RF-Lab/emg-lab/myocell_s3/readme.md

# multiboard myocell-s3 design



ADC + CPU board for multiboard MYOCELL design. Includes [ADS1298(4)](https://static.chipdip.ru/lib/395/DOC009395274.pdf) and [ESP32-S3-WROOM-2](https://www.espressif.com/sites/default/files/documentation/esp32-s3-wroom-2_datasheet_en.pdf). Design based on ideas from [HeartyPatch](https://hackaday.io/project/21046-heartypatch-a-single-lead-ecg-hr-patch-with-esp32), [Adafruit Feather ESP32-S3](https://learn.adafruit.com/assets/110822), [electronics-homeassistant-lightscontroll
](https://github.com/crgarcia12/electronics-homeassistant-lightscontroll) etc.

## Revision history
[]() Sent to rezonit 2026.03.16

* BOM: [Interactive BOM ()](https://htmlpreview.github.io/?https://github.com/RF-Lab/emg-lab/blob/main/myocell_s3/bom/ibom.html)

### Top View
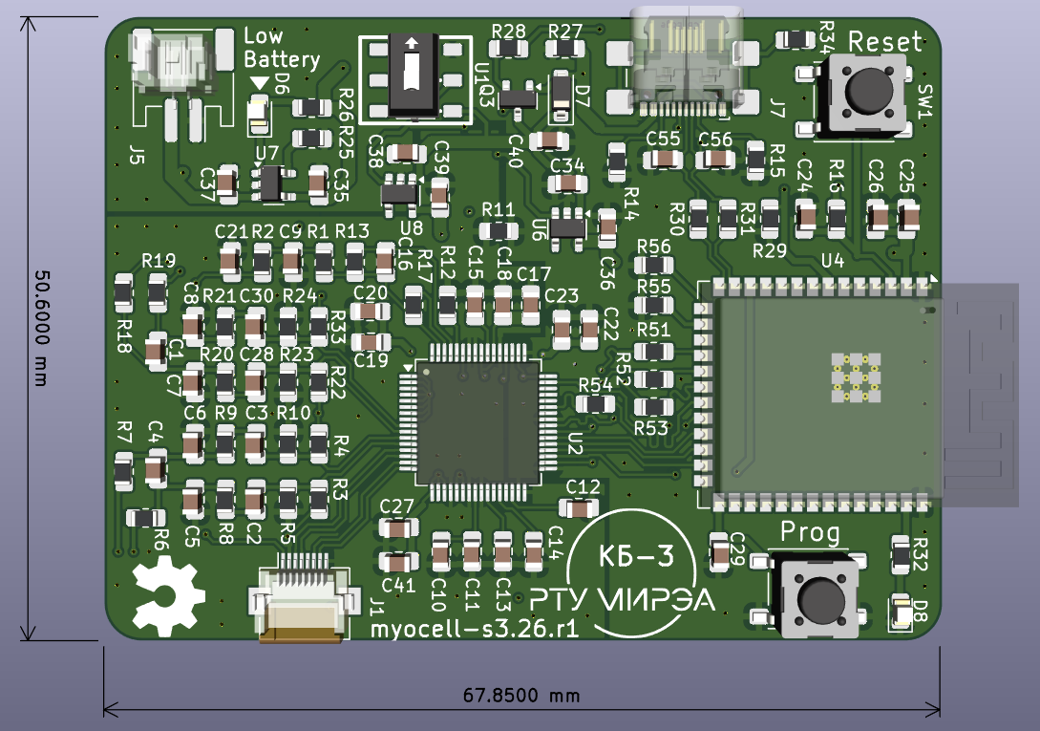
[picture p1: myocell_s3/3d.png]


### Bottom View
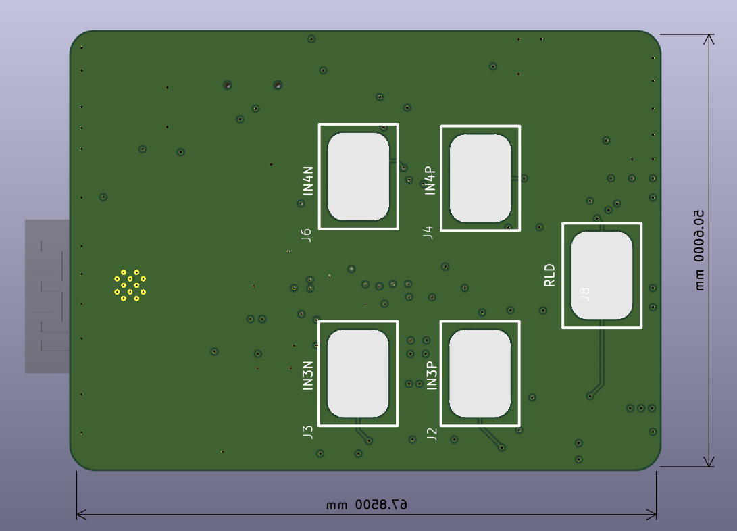
[picture p2: myocell_s3/3d_back.png]


## Gerbers

### Top+Silkscreen
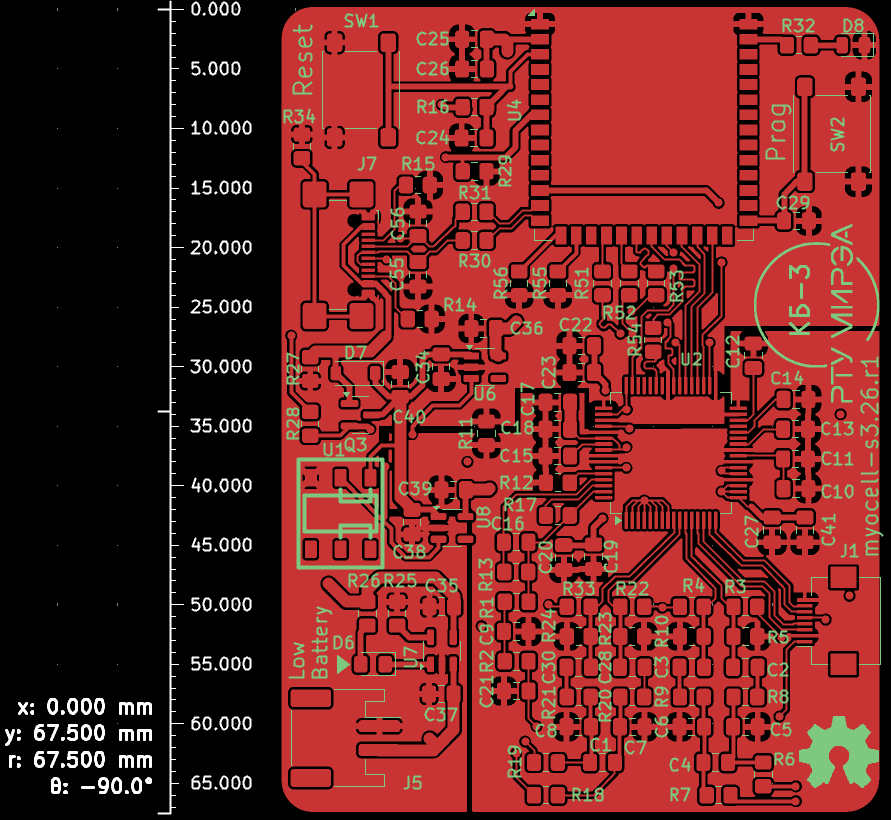
[picture p3: myocell_s3/g_top.png]


### Inner 1 (under the top)
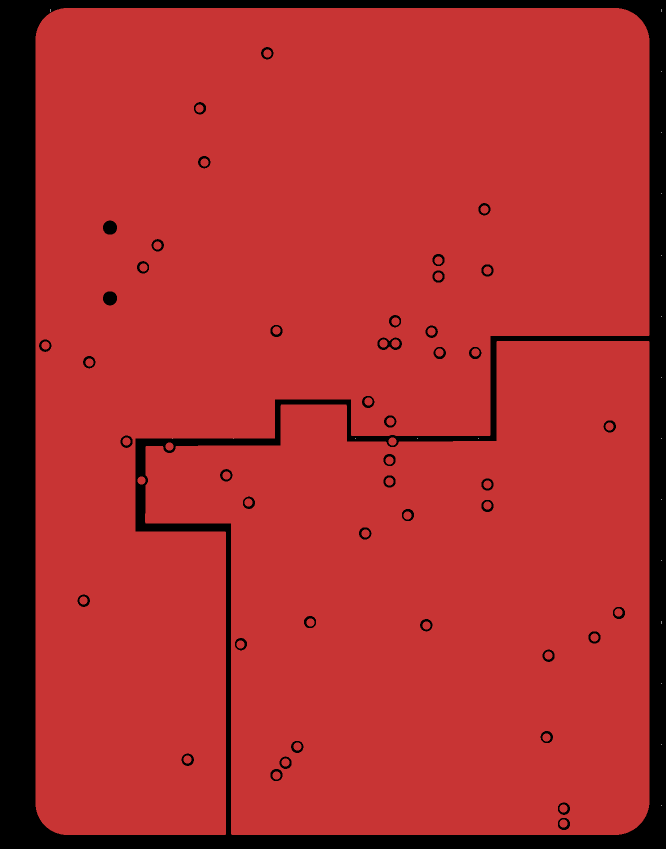
[picture p4: myocell_s3/g_in1.png]


### Inner 2
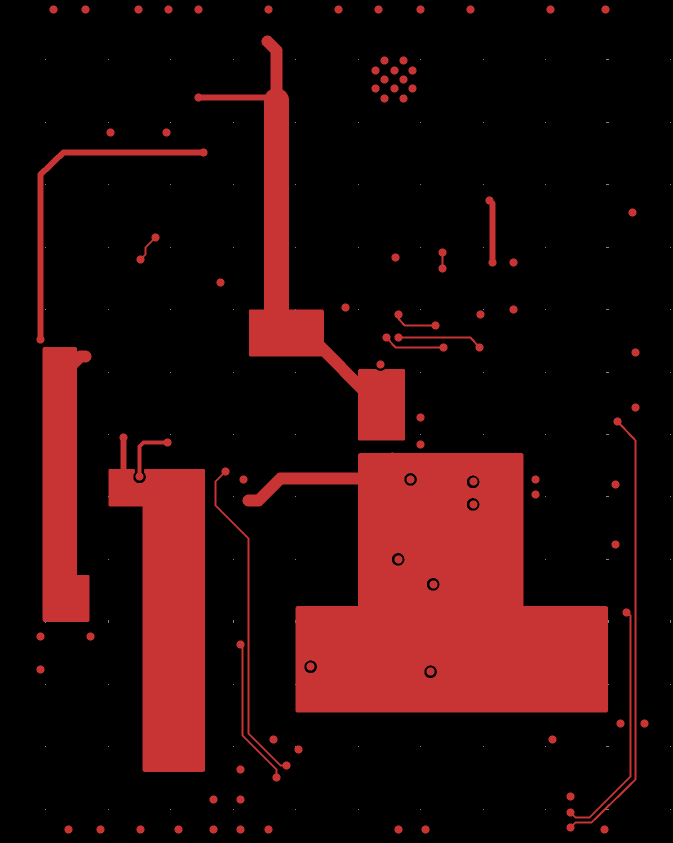
[picture p5: myocell_s3/g_in2.png]


### Bottom+Silkscreen
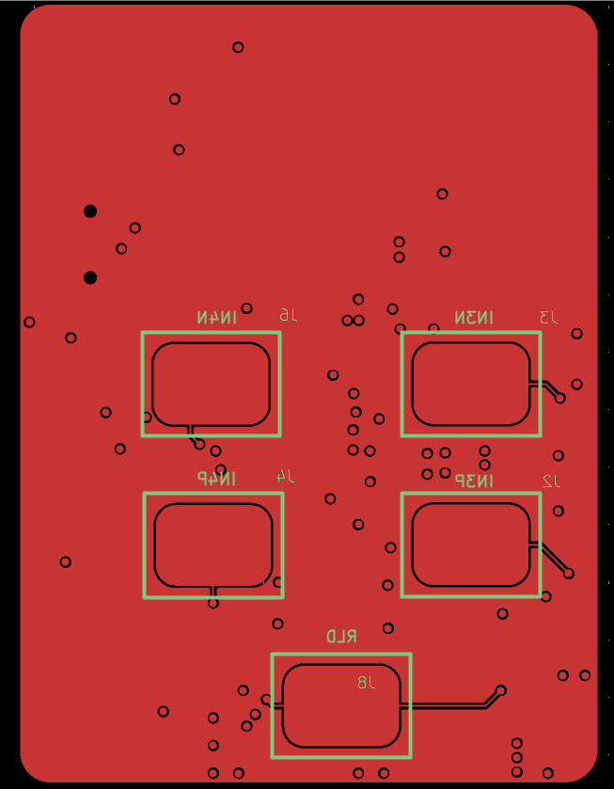
[picture p6: myocell_s3/g_bot.png]


## Dependencies

* [Espressif KiCad Library](https://github.com/espressif/kicad-libraries)
