RF-Lab/emg-lab/myocell_s3/myocell_s3.pdf

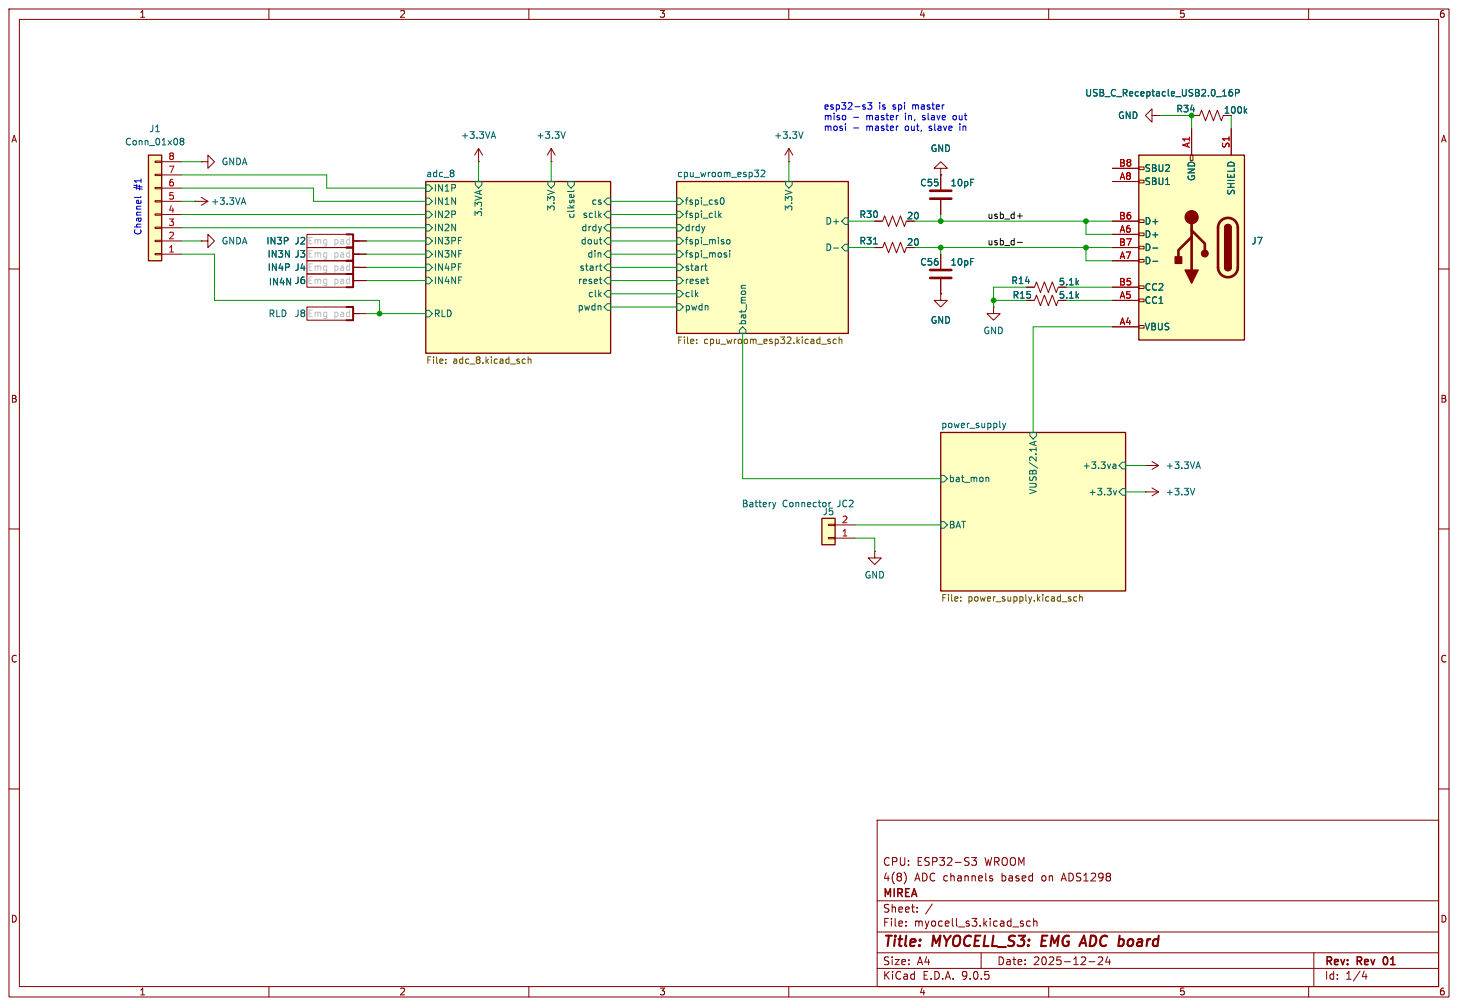
[picture p7: page 1]

clk clksel start dout drdy

IN3N J3 Emg pad
IN4P J4 Emg pad
IN4N J6 Emg pad RLD J8 Emg pad

Id: 1/4 Title: MYOCELL_S3: EMG ADC board

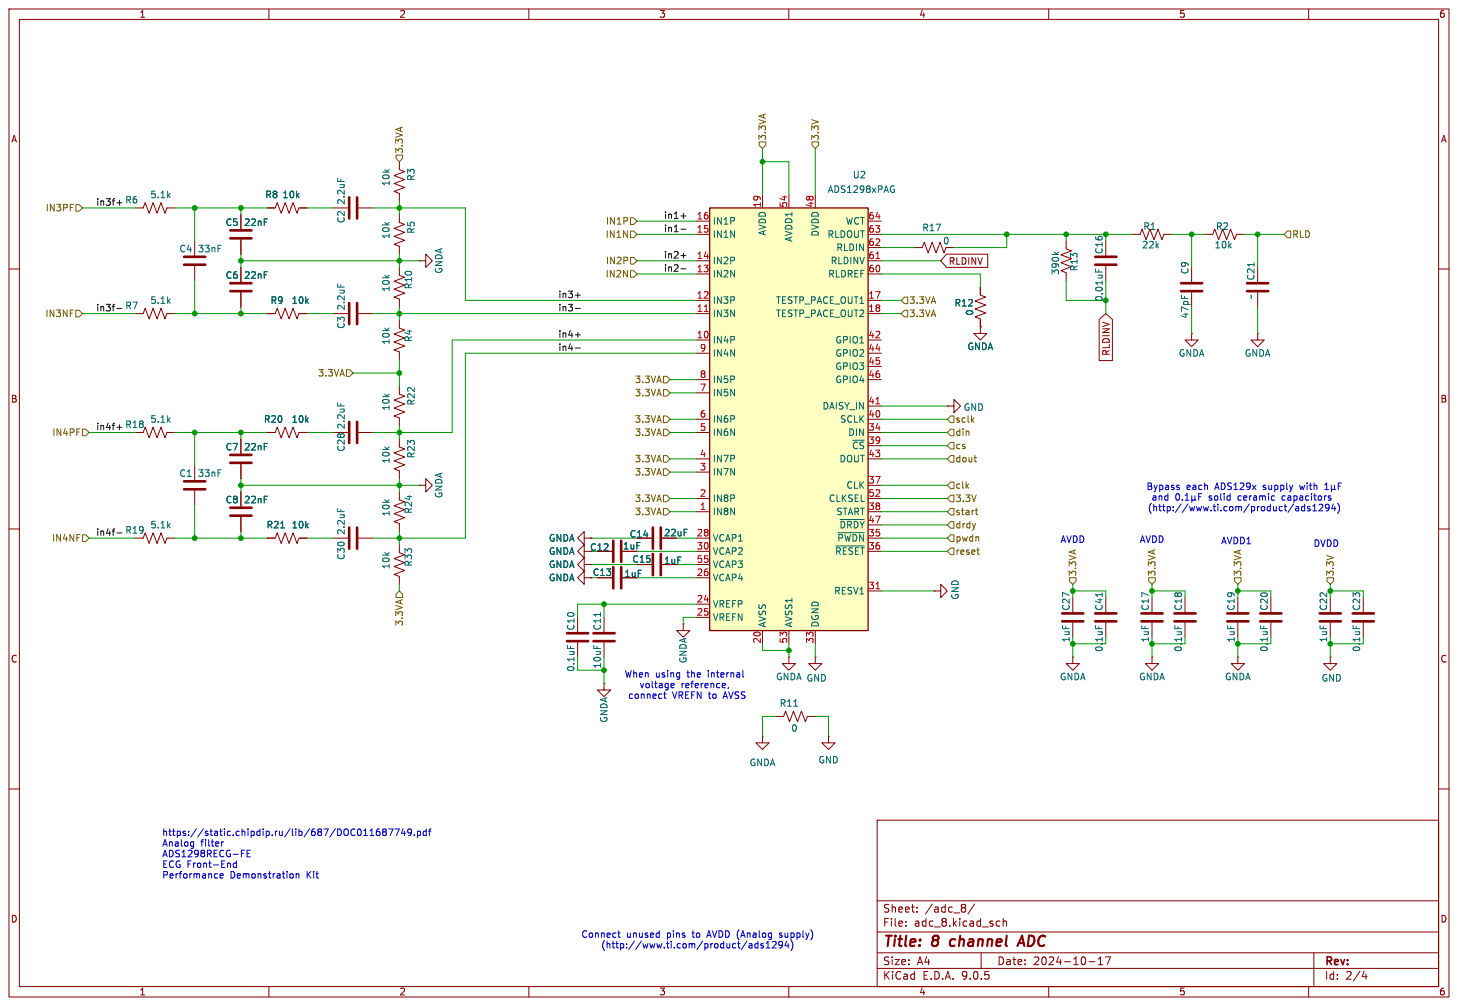
[picture p8: page 2]

(http://www.ti.com/product/ads1294) Connect unused pins to AVDD (Analog supply)

and þÿ0.1¼F solid ceramic capacitors

https://static.chipdip.ru/lib/687/DOC011687749.pdf
Analog filter ADS1298RECG-FE

File: adc_8.kicad_sch Sheet: /adc_8/
Id: 2/4 Title: 8 channel ADC

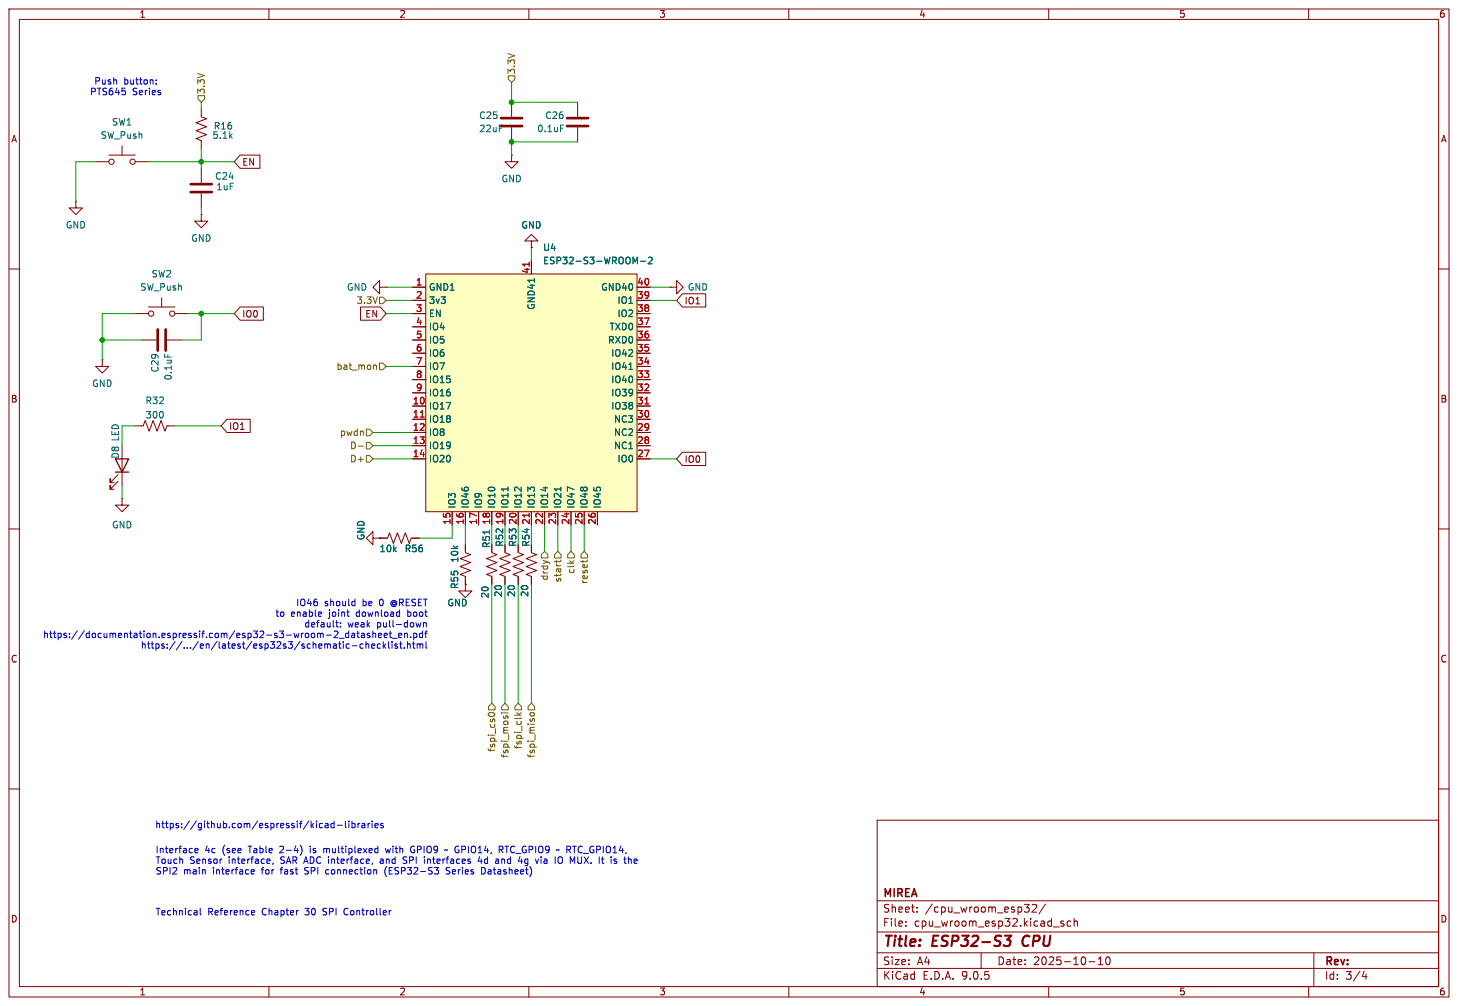
[picture p9: page 3]

https://documentation.espressif.com/esp32-s3-wroom-2_datasheet_en.pdf

https://.../en/latest/esp32s3/schematic-checklist.html

https://github.com/espressif/kicad-libraries

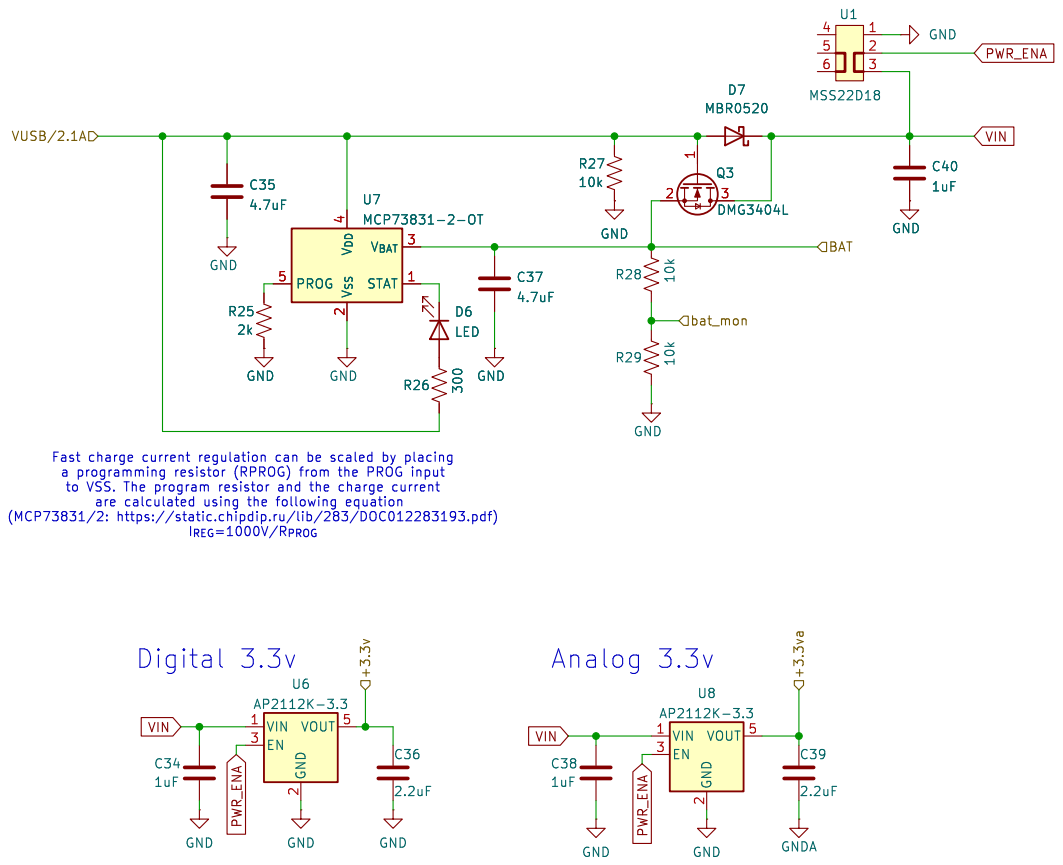
[picture p10: page 4]

MIREA/Rf-lab.org
File: power_supply.kicad_sch Sheet: /power_supply/
Id: 5/4 Title: Power supply
