RF-Lab/emg-lab/myocell_s3/myocell_s3.kicad_pcb

## KiCad design myocell_s3/myocell_s3.kicad_pcb (2026-03-15)

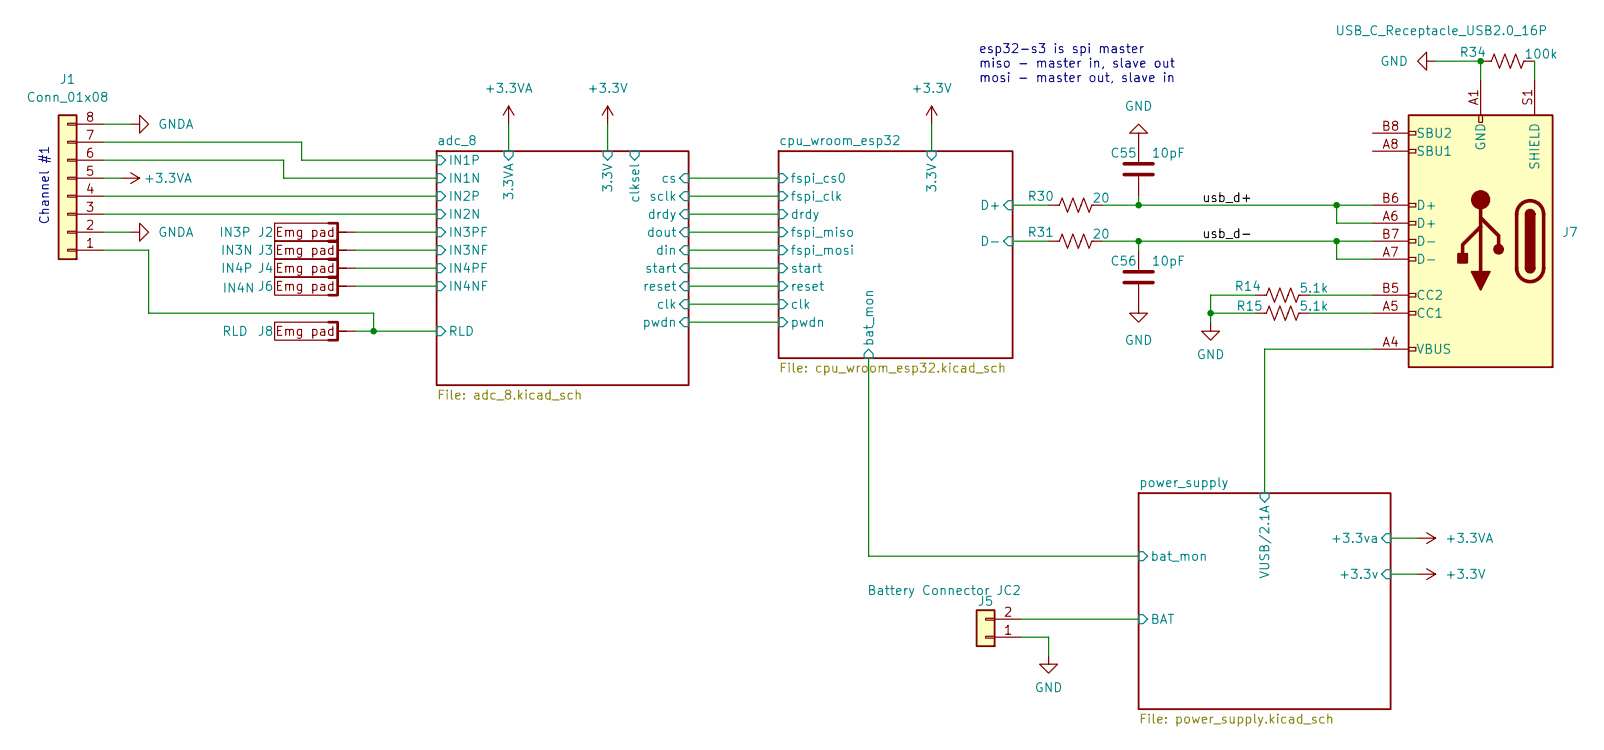
[picture p11: schematic myocell_s3.kicad_sch, MYOCELL_S3: EMG ADC board]

Parts:
C55, C56: 10pF; C_0805_2012Metric_Pad1.18x1.45mm_HandSolder
J1: Conn_01x08; Hirose_FH12-8S-0.5SH_1x08-1MP_P0.50mm_Horizontal
J2: IN3P; EMG_PAD_10_7
J3: IN3N; EMG_PAD_10_7
J4: IN4P; EMG_PAD_10_7
J5: Battery Connector JC2; JST_PH_S2B-PH-SM4-TB_1x02-1MP_P2.00mm_Horizontal
J6: IN4N; EMG_PAD_10_7
J7: USB_C_Receptacle_USB2.0_16P; USB_C_Receptacle_GCT_USB4110
J8: RLD; EMG_PAD_10_7
R14, R15: 5.1k; R_0805_2012Metric_Pad1.20x1.40mm_HandSolder
R30, R31: 20; R_0805_2012Metric_Pad1.20x1.40mm_HandSolder
R34: 100k; R_0805_2012Metric_Pad1.20x1.40mm_HandSolder

Connections:
+3.3VA: J1.5; also elsewhere on the board
/adc_8/RLD: J1.1, J8.1; also elsewhere on the board
/adc_8/in1+: J1.7; also elsewhere on the board
/adc_8/in1-: J1.6; also elsewhere on the board
/adc_8/in2+: J1.4; also elsewhere on the board
/adc_8/in2-: J1.3; also elsewhere on the board
/adc_8/in3f+: J2.1; also elsewhere on the board
/adc_8/in3f-: J3.1; also elsewhere on the board
/adc_8/in4f+: J4.1; also elsewhere on the board
/adc_8/in4f-: J6.1; also elsewhere on the board
/cpu_wroom_esp32/D+: R30.1; also elsewhere on the board
/cpu_wroom_esp32/D-: R31.1; also elsewhere on the board
/power_supply/BAT: J5.2; also elsewhere on the board
/power_supply/VUSB/2.1A: J7.A4 (VBUS), J7.A9 (VBUS), J7.B4 (VBUS), J7.B9 (VBUS); also elsewhere on the board
/usb_d+: C55.2, J7.A6 (D+), J7.B6 (D+), R30.2
/usb_d-: C56.1, J7.A7 (D-), J7.B7 (D-), R31.2
GND: C55.1, C56.2, J5.1, J7.A1 (GND), J7.A12 (GND), J7.B1 (GND), J7.B12 (GND), R14.1, R15.1, R34.1; also elsewhere on the board
GNDA: J1.2, J1.8; also elsewhere on the board
unnamed: J7.A5 (CC1), R15.2
unnamed: J7.B5 (CC2), R14.2
unnamed: J7.S1 (SHIELD), R34.2

Notes on the sheet:
esp32-s3 is spi master miso - master in, slave out mosi - master out, slave in
Channel #1

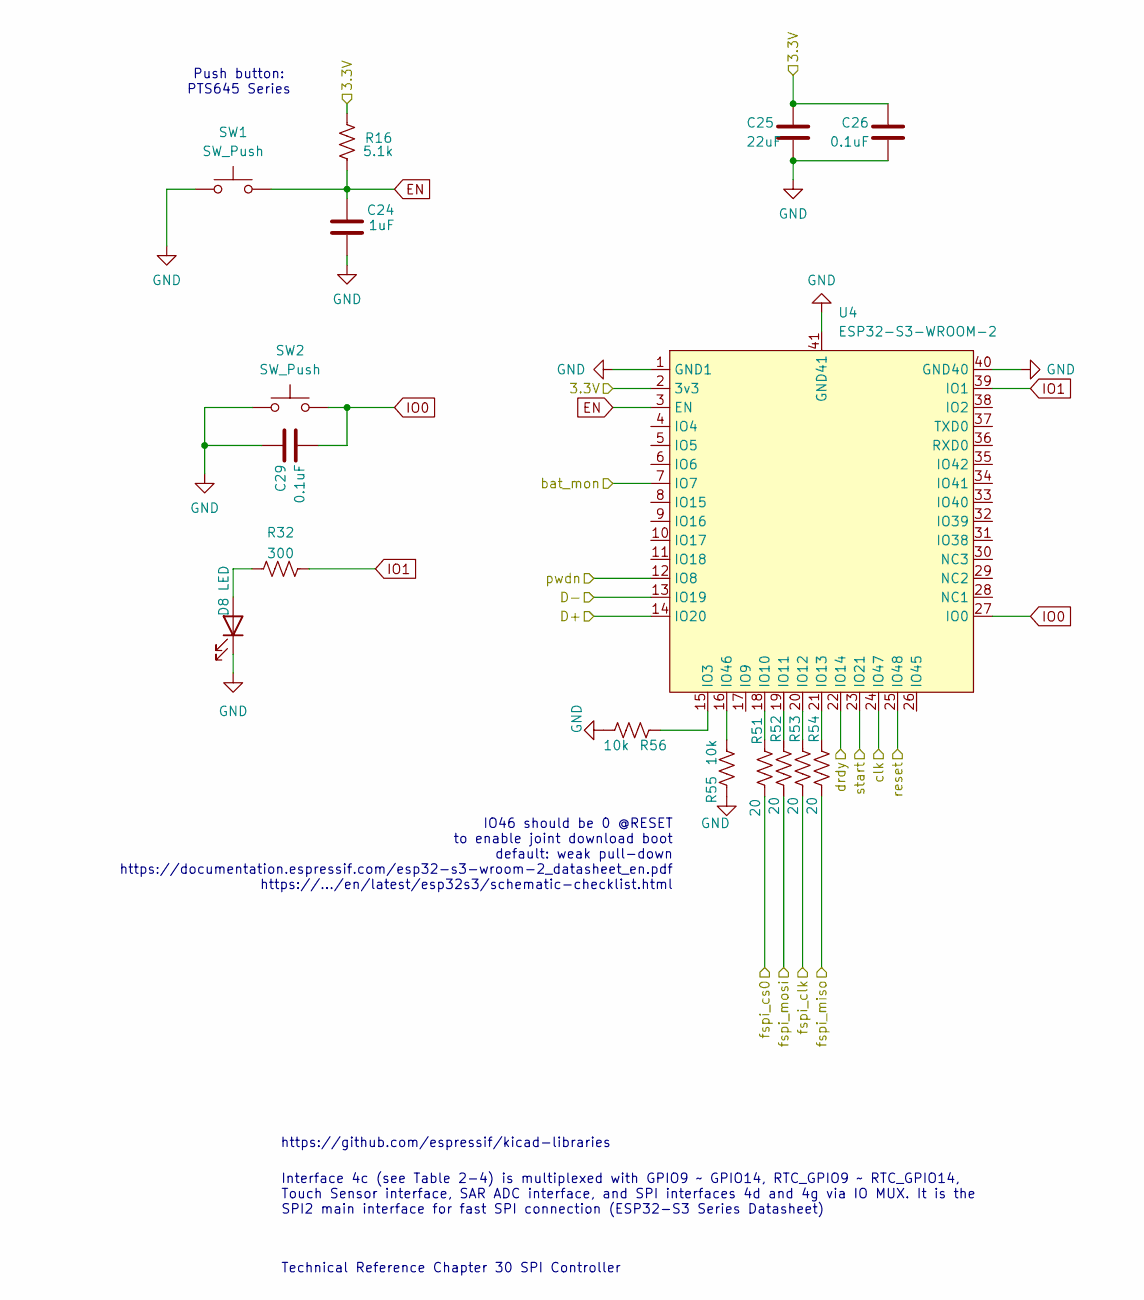
[picture p12: schematic cpu_wroom_esp32.kicad_sch, ESP32-S3 CPU]

Parts:
C24: 1uF; C_0805_2012Metric_Pad1.18x1.45mm_HandSolder
C25: 22uF; C_0805_2012Metric_Pad1.18x1.45mm_HandSolder
C26, C29: 0.1uF; C_0805_2012Metric_Pad1.18x1.45mm_HandSolder
D8: LED; LED_0805_2012Metric
R16: 5.1k; R_0805_2012Metric_Pad1.20x1.40mm_HandSolder
R32: 300; R_0805_2012Metric_Pad1.20x1.40mm_HandSolder
R51, R52, R53, R54: 20; R_0805_2012Metric_Pad1.20x1.40mm_HandSolder
R55, R56: 10k; R_0805_2012Metric_Pad1.20x1.40mm_HandSolder
SW1, SW2: SW_Push; SW_SPST_PTS645Sx43SMTR92
U4: ESP32-S3-WROOM-2

Connections:
+3.3V: C25.2, C26.2, R16.2, U4.2 (3v3); also elsewhere on the board
/adc_8/clk: U4.24 (IO47); also elsewhere on the board
/adc_8/cs: R51.1; also elsewhere on the board
/adc_8/din: R52.1; also elsewhere on the board
/adc_8/dout: R54.1; also elsewhere on the board
/adc_8/drdy: U4.22 (IO14); also elsewhere on the board
/adc_8/pwdn: U4.12 (IO8); also elsewhere on the board
/adc_8/reset: U4.25 (IO48); also elsewhere on the board
/adc_8/sclk: R53.1; also elsewhere on the board
/adc_8/start: U4.23 (IO21); also elsewhere on the board
/cpu_wroom_esp32/D+: U4.14 (IO20); also elsewhere on the board
/cpu_wroom_esp32/D-: U4.13 (IO19); also elsewhere on the board
/cpu_wroom_esp32/bat_mon: U4.7 (IO7); also elsewhere on the board
EN: C24.2, R16.1, SW1.2, U4.3 (EN)
GND: C24.1, C25.1, C26.1, C29.2, D8.1 (K), R55.1, R56.2, SW1.1, SW2.1, U4.1 (GND1), U4.40 (GND40), U4.41 (GND41); also elsewhere on the board
IO0: C29.1, SW2.2, U4.27 (IO0)
IO1: R32.2, U4.39 (IO1)
unnamed: D8.2 (A), R32.1
unnamed: R56.1, U4.15 (IO3)
unnamed: R51.2, U4.18 (IO10)
unnamed: R52.2, U4.19 (IO11)
unnamed: R53.2, U4.20 (IO12)
unnamed: R54.2, U4.21 (IO13)
unnamed: R55.2, U4.16 (IO46)

Notes on the sheet:
Technical Reference Chapter 30 SPI Controller
IO46 should be 0 @RESET to enable joint download boot default: weak pull-down https://documentation.espressif.com/esp32-s3-wroom-2_datasheet_en.pdf https://.../en/latest/esp32s3/schematic-checklist.html
Interface 4c (see Table 2-4) is multiplexed with GPIO9 ~ GPIO14, RTC_GPIO9 ~ RTC_GPIO14, Touch Sensor interface, SAR ADC interface, and SPI interfaces 4d and 4g via IO MUX. It is the SPI2 main interface for fast SPI connection (ESP32-S3 Series Datasheet)
Push button: PTS645 Series
https://github.com/espressif/kicad-libraries

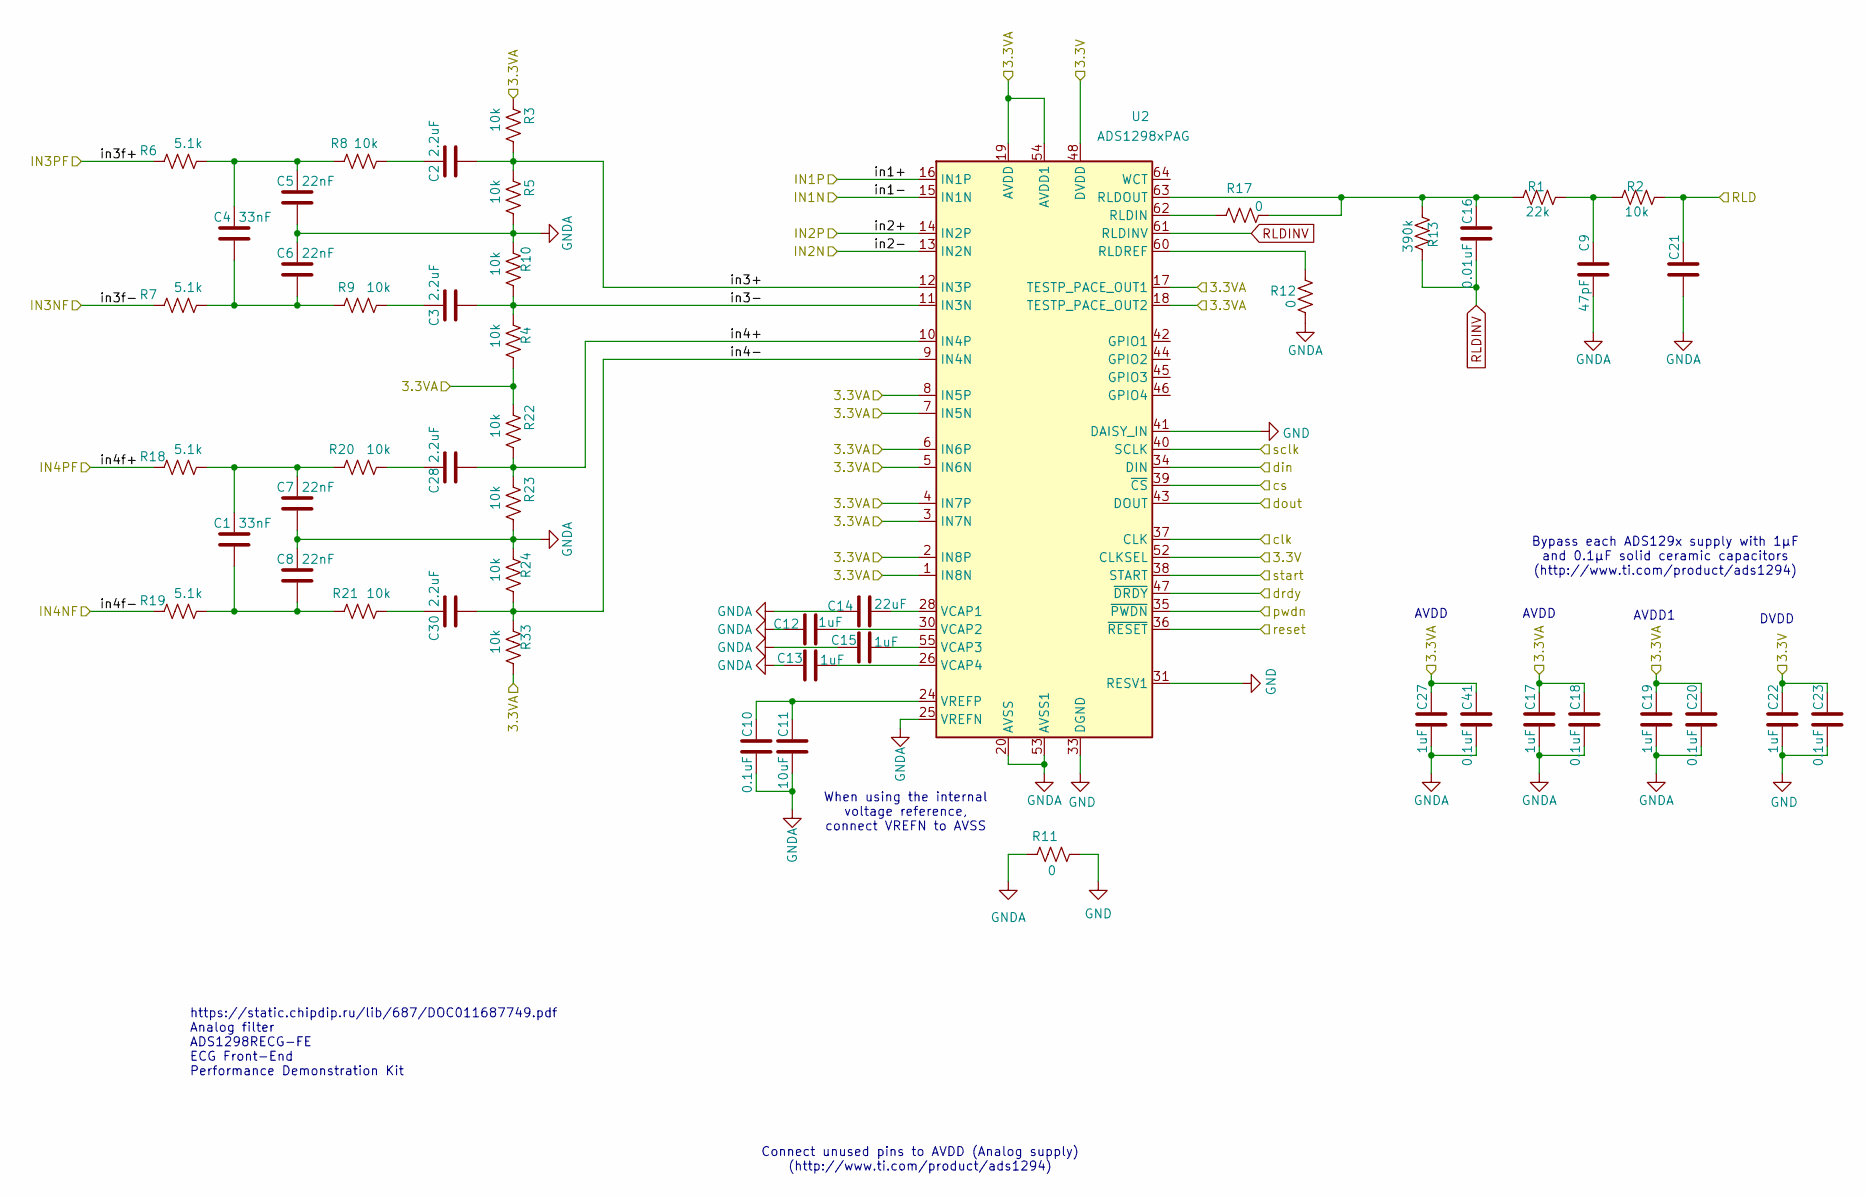
[picture p13: schematic adc_8.kicad_sch, 8 channel ADC]

Parts:
C1, C4: 33nF; C_0805_2012Metric_Pad1.18x1.45mm_HandSolder
C2, C3, C28, C30: 2.2uF; C_0805_2012Metric_Pad1.18x1.45mm_HandSolder
C5, C6, C7, C8: 22nF; C_0805_2012Metric_Pad1.18x1.45mm_HandSolder
C9: 47pF; C_0805_2012Metric_Pad1.18x1.45mm_HandSolder
C10, C18, C20, C23, C41: 0.1uF; C_0805_2012Metric_Pad1.18x1.45mm_HandSolder
C11: 10uF; C_0805_2012Metric_Pad1.18x1.45mm_HandSolder
C12, C13, C15, C17, C19, C22, C27: 1uF; C_0805_2012Metric_Pad1.18x1.45mm_HandSolder
C14: 22uF; C_0805_2012Metric_Pad1.18x1.45mm_HandSolder
C16: 0.01uF; C_0805_2012Metric_Pad1.18x1.45mm_HandSolder
C21: C_0805_2012Metric_Pad1.18x1.45mm_HandSolder
R1: 22k; R_0805_2012Metric_Pad1.20x1.40mm_HandSolder
R2, R3, R4, R5, R8, R9, R10, R20, R21, R22, R23, R24, R33: 10k; R_0805_2012Metric_Pad1.20x1.40mm_HandSolder
R6, R7, R18, R19: 5.1k; R_0805_2012Metric_Pad1.20x1.40mm_HandSolder
R11, R12, R17: 0; R_0805_2012Metric_Pad1.20x1.40mm_HandSolder
R13: 390k; R_0805_2012Metric_Pad1.20x1.40mm_HandSolder
U2: ADS1298xPAG; TQFP-64_10x10mm_P0.5mm

Connections:
+3.3V: C22.2, C23.2, U2.48 (DVDD), U2.50 (DVDD), U2.52 (CLKSEL); also elsewhere on the board
+3.3VA: C17.2, C18.2, C19.2, C20.2, C27.2, C41.2, R3.2, R4.1, R22.2, R33.1, U2.1 (IN8N), U2.2 (IN8P), U2.3 (IN7N), U2.4 (IN7P), U2.5 (IN6N), U2.6 (IN6P), U2.7 (IN5N), U2.8 (IN5P), U2.17 (TESTP_PACE_OUT1), U2.18 (TESTP_PACE_OUT2), U2.19 (AVDD), U2.21 (AVDD), U2.22 (AVDD), U2.54 (AVDD1), U2.56 (AVDD), U2.59 (AVDD); also elsewhere on the board
/adc_8/RLD: C21.2, R2.2; also elsewhere on the board
/adc_8/clk: U2.37 (CLK); also elsewhere on the board
/adc_8/cs: U2.39 (~CS); also elsewhere on the board
/adc_8/din: U2.34 (DIN); also elsewhere on the board
/adc_8/dout: U2.43 (DOUT); also elsewhere on the board
/adc_8/drdy: U2.47 (~DRDY); also elsewhere on the board
/adc_8/in1+: U2.16 (IN1P); also elsewhere on the board
/adc_8/in1-: U2.15 (IN1N); also elsewhere on the board
/adc_8/in2+: U2.14 (IN2P); also elsewhere on the board
/adc_8/in2-: U2.13 (IN2N); also elsewhere on the board
/adc_8/in3+: C2.2, R3.1, R5.2, U2.12 (IN3P)
/adc_8/in3-: C3.2, R4.2, R10.1, U2.11 (IN3N)
/adc_8/in3f+: R6.1; also elsewhere on the board
/adc_8/in3f-: R7.1; also elsewhere on the board
/adc_8/in4+: C28.2, R22.1, R23.2, U2.10 (IN4P)
/adc_8/in4-: C30.2, R24.1, R33.2, U2.9 (IN4N)
/adc_8/in4f+: R18.1; also elsewhere on the board
/adc_8/in4f-: R19.1; also elsewhere on the board
/adc_8/pwdn: U2.35 (~PWDN); also elsewhere on the board
/adc_8/reset: U2.36 (~RESET); also elsewhere on the board
/adc_8/sclk: U2.40 (SCLK); also elsewhere on the board
/adc_8/start: U2.38 (START); also elsewhere on the board
GND: C22.1, C23.1, R11.1, U2.31 (RESV1), U2.33 (DGND), U2.41 (DAISY_IN), U2.49 (DGND), U2.51 (DGND); also elsewhere on the board
GNDA: C5.2, C6.1, C7.2, C8.1, C9.1, C10.1, C11.1, C12.2, C13.2, C14.2, C15.2, C17.1, C18.1, C19.1, C20.1, C21.1, C27.1, C41.1, R5.1, R10.2, R11.2, R12.1, R23.1, R24.2, U2.20 (AVSS), U2.23 (AVSS), U2.25 (VREFN), U2.32 (AVSS), U2.53 (AVSS1), U2.57 (AVSS), U2.58 (AVSS); also elsewhere on the board
unnamed: C1.1, C7.1, R18.2, R20.1
unnamed: C1.2, C8.2, R19.2, R21.1
unnamed: C2.1, R8.2
unnamed: C3.1, R9.2
unnamed: C4.1, C5.1, R6.2, R8.1
unnamed: C4.2, C6.2, R7.2, R9.1
unnamed: C9.2, R1.2, R2.1
unnamed: C28.1, R20.2
unnamed: C30.1, R21.2
unnamed: R17.2, U2.62 (RLDIN)
unnamed: C16.2, R1.1, R13.1, R17.1, U2.63 (RLDOUT)
unnamed: R12.2, U2.60 (RLDREF)
unnamed: C14.1, U2.28 (VCAP1)
unnamed: C12.1, U2.30 (VCAP2)
unnamed: C15.1, U2.55 (VCAP3)
unnamed: C13.1, U2.26 (VCAP4)
unnamed: C10.2, C11.2, U2.24 (VREFP)
RLDINV: C16.1, R13.2, U2.61 (RLDINV)

Notes on the sheet:
When using the internal voltage reference, connect VREFN to AVSS
DVDD
Connect unused pins to AVDD (Analog supply) (http://www.ti.com/product/ads1294)
AVDD
AVDD1
Bypass each ADS129x supply with 1μF and 0.1μF solid ceramic capacitors (http://www.ti.com/product/ads1294)
https://static.chipdip.ru/lib/687/DOC011687749.pdf Analog filter ADS1298RECG-FE ECG Front-End Performance Demonstration Kit

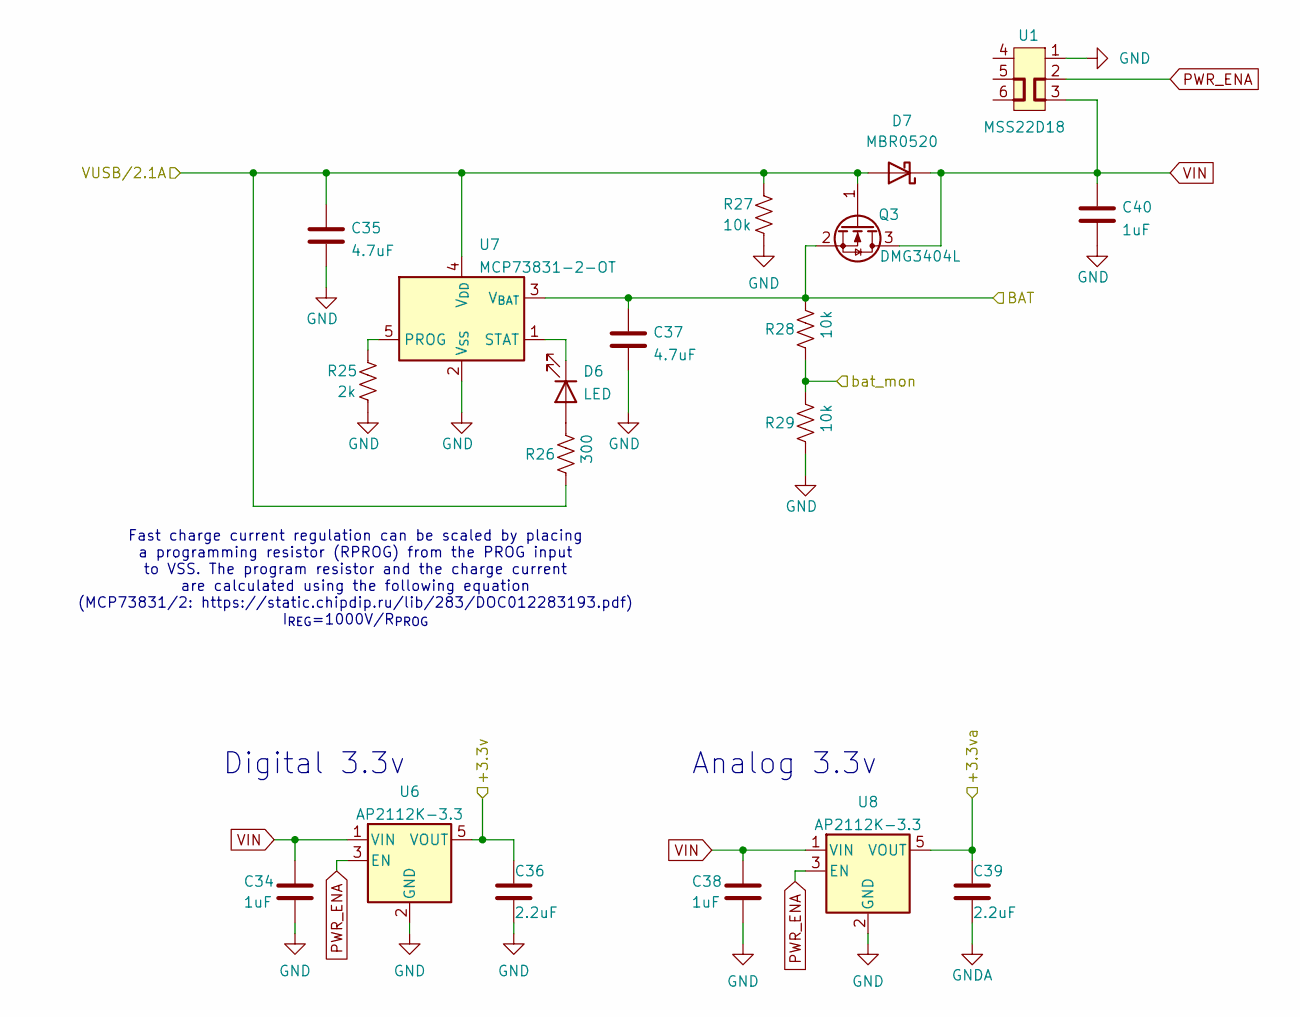
[picture p14: schematic power_supply.kicad_sch, Power supply]

Parts:
C34, C38, C40: 1uF; C_0805_2012Metric_Pad1.18x1.45mm_HandSolder
C35, C37: 4.7uF; C_0805_2012Metric_Pad1.18x1.45mm_HandSolder
C36, C39: 2.2uF; C_0805_2012Metric_Pad1.18x1.45mm_HandSolder
D6: LED; LED_0805_2012Metric_Pad1.15x1.40mm_HandSolder
D7: MBR0520; D_SOD-123
Q3: DMG3404L; SOT-23
R25: 2k; R_0805_2012Metric_Pad1.20x1.40mm_HandSolder
R26: 300; R_0805_2012Metric_Pad1.20x1.40mm_HandSolder
R27, R28, R29: 10k; R_0805_2012Metric_Pad1.20x1.40mm_HandSolder
U1: MSS22D18
U6, U8: AP2112K-3.3; SOT-23-5
U7: MCP73831-2-OT; SOT-23-5

Connections:
+3.3V: C36.2, U6.5 (VOUT); also elsewhere on the board
+3.3VA: C39.2, U8.5 (VOUT); also elsewhere on the board
/cpu_wroom_esp32/bat_mon: R28.1, R29.2; also elsewhere on the board
/power_supply/BAT: C37.1, Q3.2 (S), R28.2, U7.3 (V_{BAT}); also elsewhere on the board
/power_supply/VUSB/2.1A: C35.2, D7.2 (A), Q3.1 (G), R26.1, R27.2, U7.4 (V_{DD}); also elsewhere on the board
GND: C34.1, C35.1, C36.1, C37.2, C38.1, C40.1, R25.1, R27.1, R29.1, U1.1, U6.2 (GND), U7.2 (V_{SS}), U8.2 (GND); also elsewhere on the board
GNDA: C39.1; also elsewhere on the board
unnamed: D6.2 (A), R26.2
unnamed: D6.1 (K), U7.1 (STAT)
unnamed: R25.2, U7.5 (PROG)
PWR_ENA: U1.2, U6.3 (EN), U8.3 (EN)
VIN: C34.2, C38.2, C40.2, D7.1 (K), Q3.3 (D), U1.3, U6.1 (VIN), U8.1 (VIN)

Notes on the sheet:
Fast charge current regulation can be scaled by placing a programming resistor (RPROG) from the PROG input to VSS. The program resistor and the charge current are calculated using the following equation (MCP73831/2: https://static.chipdip.ru/lib/283/DOC012283193.pdf) I_{REG}=1000V/R_{PROG}
Analog 3.3v
Digital 3.3v

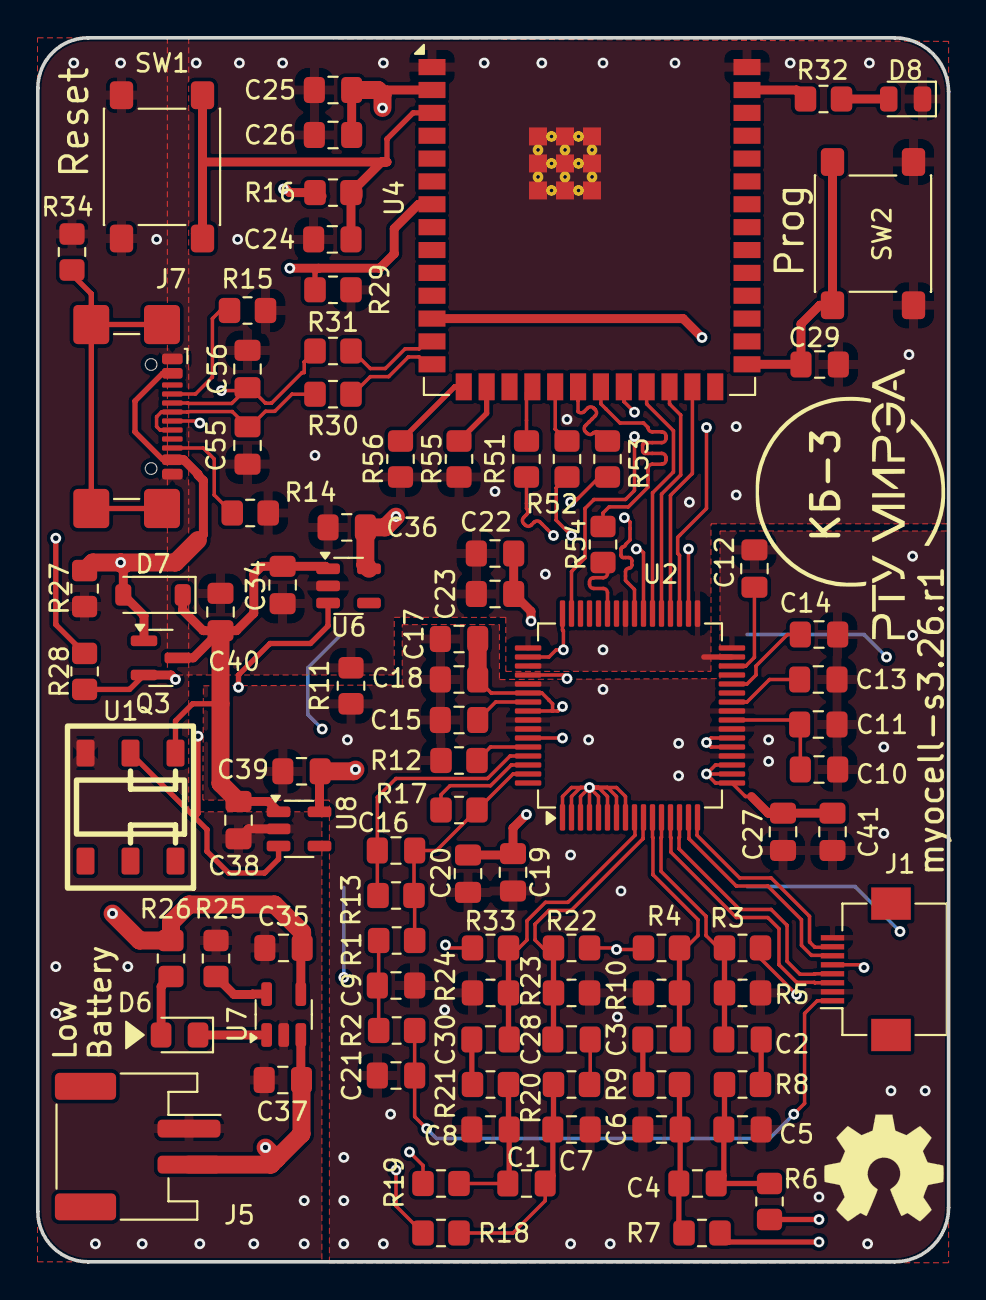
[picture p15: board myocell_s3.kicad_pcb from above]

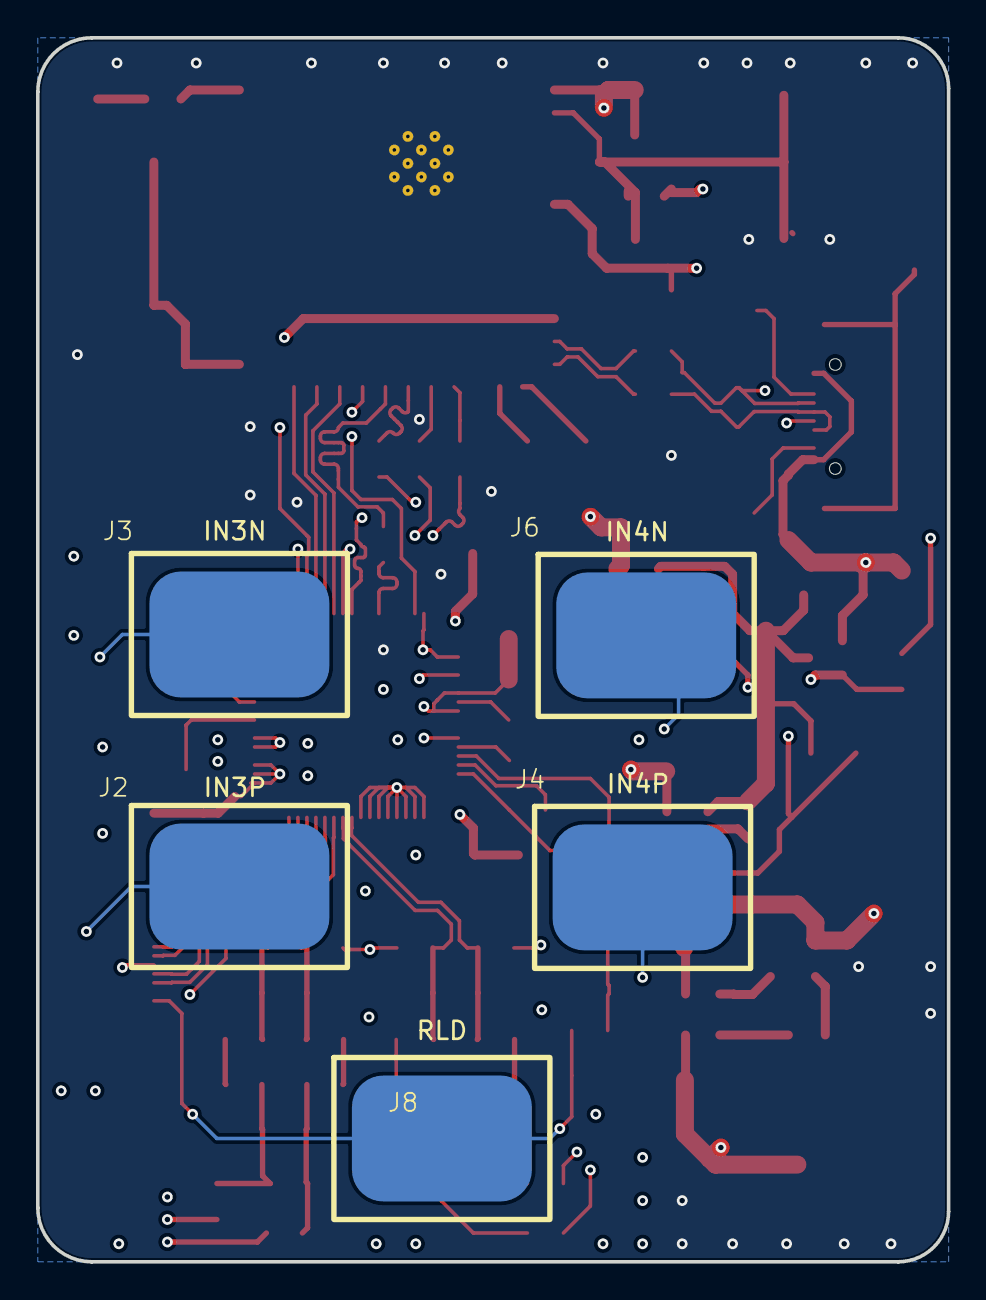
[picture p16: board myocell_s3.kicad_pcb from below]

Board: 4 copper layers, 50.6 x 68.0 mm, 100 parts (5 on the bottom side), 69 nets.
