RF-Lab/emg-lab/emg8x-s3.26.r1/main/app_main.c

//
// Copyright 2019-2026 rf-lab.org
// (MIREA KB-2( frmly. MIREA KB-3, MGUPI IT-6 "Control and simulation in technical systems"))
//
// Licensed under the Apache License, Version 2.0 (the "License");
// you may not use this file except in compliance with the License.
// You may obtain a copy of the License at

//     http://www.apache.org/licenses/LICENSE-2.0
//
// Unless required by applicable law or agreed to in writing, software
// distributed under the License is distributed on an "AS IS" BASIS,
// WITHOUT WARRANTIES OR CONDITIONS OF ANY KIND, either express or implied.
// See the License for the specific language governing permissions and
// limitations under the License.

// EMG-8x/app_main.c - main source file for EMG-8x hardware platform
// Please refer to:

// EMG platform
//      https://github.com/RF-Lab/emg_platform

// How to install SDK for ESP32 under Windows(r)
//      http://rf-lab.org/news/2020/04/04/esp-idf.html

// List of modifications:
//      https://github.com/RF-Lab/emg_platform/commits/master/source/esp32/emg8x/main/app_main.c
//

#include <stdio.h>
#include <stdint.h>
#include <stddef.h>
#include <string.h>
#include "esp_wifi.h"
#include "esp_system.h"
#include "nvs_flash.h"
#include "esp_event.h"

#include "freertos/FreeRTOS.h"
#include "freertos/task.h"
#include "freertos/semphr.h"
#include "freertos/queue.h"
#include "freertos/event_groups.h"

#include "lwip/sockets.h"
#include "lwip/dns.h"
#include "lwip/netdb.h"

#include "esp_log.h"
#include "hal/gpio_types.h"
#include "driver/gpio.h"
#include "driver/spi_master.h"
#include "esp_attr.h"

#include  "esp_chip_info.h"

static const char *TAG                          = "EMG8x" ;

// Pinout mapping
// Use pinout rules from here: (https://randomnerdtutorials.com/esp32-pinout-reference-gpios/)
// NodeMCU 32-s2 pinout: (https://www.instructables.com/id/ESP32-Internal-Details-and-Pinout/)

// DEBUG purpose pins
//static const gpio_num_t     DEBUG_PIN1          = GPIO_NUM_27 ;         // Debug pin #1
static const gpio_num_t         ESP_LED1          = GPIO_NUM_2 ;         // Debug pin #1

static const gpio_num_t     AD1299_PWDN_PIN     = GPIO_NUM_8 ;          // ADS<--ESP Power down pin (active low)
static const gpio_num_t     AD1299_RESET_PIN    = GPIO_NUM_48 ;         // ADS<--ESP Reset pin (active low)
static const gpio_num_t     AD1299_DRDY_PIN     = GPIO_NUM_14 ;         // ADS-->ESP DRDY pin (active low)
static const gpio_num_t     AD1299_START_PIN    = GPIO_NUM_21 ;         // ADS<--ESP Start data conversion pint (active high)

// SPI comands (see https://www.ti.com/lit/ds/symlink/ads1299.pdf?ts=1599826124971)
static const uint8_t        AD1299_CMD_RREG     = 0x20 ;                // Read register
static const uint8_t        AD1299_CMD_WREG     = 0x40 ;                // Write to register
static const uint8_t        AD1299_CMD_RDATAC   = 0x10 ;                // Start continouous mode
static const uint8_t        AD1299_CMD_SDATAC   = 0x11 ;                // Stop continuous mode

// Register addresses available through SPI (see https://www.ti.com/lit/ds/symlink/ads1299.pdf?ts=1599826124971)
static const uint8_t        AD1299_ADDR_ID      = 0x00 ;                // ID register
static const uint8_t        AD1299_ADDR_CONFIG1 = 0x01 ;                // CONFIG1 register
static const uint8_t        AD1299_ADDR_CONFIG2 = 0x02 ;                // CONFIG2 register
static const uint8_t        AD1299_ADDR_CONFIG3 = 0x03 ;                // CONFIG3 register
static const uint8_t        AD1299_ADDR_LEADOFF = 0x04 ;
static const uint8_t        AD1299_ADDR_CH1SET  = 0x05 ;
static const uint8_t        AD1299_ADDR_CH2SET  = 0x06 ;
static const uint8_t        AD1299_ADDR_CH3SET  = 0x07 ;
static const uint8_t        AD1299_ADDR_CH4SET  = 0x08 ;
static const uint8_t        AD1299_ADDR_CH5SET  = 0x09 ;
static const uint8_t        AD1299_ADDR_CH6SET  = 0x0a ;
static const uint8_t        AD1299_ADDR_CH7SET  = 0x0b ;
static const uint8_t        AD1299_ADDR_CH8SET  = 0x0c ;

// AD1299 constants (see https://www.ti.com/lit/ds/symlink/ads1299.pdf?ts=1599826124971)
// Number of analog channels
#define                     AD1299_NUM_CH                   8

// Transport protocol constants

// Transport header size (bytes), use 'idf.py menuconfig' to change this constant
// CONFIG_EMG8X_TRANSPORT_BLOCK_HEADER_SIZE =               16

// Offset to packet counter in 32 bit words, use 'idf.py menuconfig' to change this constant
// CONFIG_EMG8X_PKT_COUNT_OFFSET =                          2

// Number of 32bit samples per transport block, use 'idf.py menuconfig' to change this constant
// CONFIG_EMG8X_SAMPLES_PER_TRANSPORT_BLOCK =               64

// Device thread to transport queue size, use 'idf.py menuconfig' to change this constant
// Number of transport blocks to queue
// CONFIG_EMG8X_TRANSPORT_QUE_SIZE =                        2

// TCP server port to listen, use 'idf.py menuconfig' to change this constant
// CONFIG_EMG8X_TCP_SERVER_PORT =                           3000


IRAM_ATTR void spi_data_pump_task( void* pvParameter ) ;

DRAM_ATTR spi_device_handle_t         spi_dev ;

DRAM_ATTR TaskHandle_t      tcpTaskHandle ;
DRAM_ATTR TaskHandle_t      datapumpTaskHandle ;

int num_phys_channels = -1 ; // Number of physical channel on chip
int phys_block_size = -1 ; // Number of bits to read from device

// DRDY signal interrupt context
typedef struct
{
    SemaphoreHandle_t       xSemaphore ;
} type_drdy_isr_context ;
DRAM_ATTR type_drdy_isr_context       drdy_isr_context ;

// ADC data variables combined into the structure
typedef struct
{

    uint8_t                 spiReadBuffer [32] ;            // Buffer to receive raw data from ADS1299 th SPI transaction

    uint32_t                adcStat32 ;                     // STAT field of last transaction in 32bit form (only 24bits used)

    // ISR to thread data queue
    int                     head ;          // 0 to CONFIG_EMG8X_TRANSPORT_QUE_SIZE-1
    int                     tail ;          // 0 to CONFIG_EMG8X_TRANSPORT_QUE_SIZE-1

    int                     sampleCount ;   // 0 to CONFIG_EMG8X_SAMPLES_PER_TRANSPORT_BLOCK-1

    uint32_t                blockCounter ;  // Number of received from ADC data blocks (num of full transport blocks)

    // read by thread, written by isr
    int32_t                 adcDataQue[CONFIG_EMG8X_TRANSPORT_QUE_SIZE][(CONFIG_EMG8X_TRANSPORT_BLOCK_HEADER_SIZE)/sizeof(int32_t)+(AD1299_NUM_CH+1)*(CONFIG_EMG8X_SAMPLES_PER_TRANSPORT_BLOCK)] ;

    // Counting semaphore represents number of transport blocks queued for
    // TCP delivery task
    SemaphoreHandle_t       xDataQueueSemaphore ;
    SemaphoreHandle_t       headTailMutex ;

} type_drdy_thread_context ;
DRAM_ATTR type_drdy_thread_context    drdy_thread_context ;

// TCP Server context
typedef struct
{

    // Pointer to ADC data
    type_drdy_thread_context*   pDrdyThreadContext ;
    char                        serverIpAddr[128] ;

} type_tcp_server_thread_context ;
DRAM_ATTR type_tcp_server_thread_context tcp_server_thread_context ;

#if CONFIG_WIFI_MODE_SOFTAP

static void wifi_event_handler(void* arg, esp_event_base_t event_base,
                                    int32_t event_id, void* event_data)
{
    if (event_id == WIFI_EVENT_AP_STACONNECTED)
    {
        wifi_event_ap_staconnected_t* event = (wifi_event_ap_staconnected_t*) event_data;
        ESP_LOGI(TAG, "station "MACSTR" join, AID=%d",
                 MAC2STR(event->mac), event->aid);
    } else if (event_id == WIFI_EVENT_AP_STADISCONNECTED) {
        wifi_event_ap_stadisconnected_t* event = (wifi_event_ap_stadisconnected_t*) event_data;
        ESP_LOGI(TAG, "station "MACSTR" leave, AID=%d",
                 MAC2STR(event->mac), event->aid);
    }
}

 esp_netif_ip_info_t ap_ip_info ;
void wifi_init_softap(void)
{
    ESP_ERROR_CHECK(esp_netif_init()) ;
    ESP_ERROR_CHECK(esp_event_loop_create_default()) ;
    esp_netif_create_default_wifi_ap() ;

    wifi_init_config_t cfg = WIFI_INIT_CONFIG_DEFAULT() ;
    ESP_ERROR_CHECK(esp_wifi_init(&cfg)) ;

    ESP_ERROR_CHECK(esp_event_handler_instance_register(WIFI_EVENT,
                                                        ESP_EVENT_ANY_ID,
                                                        &wifi_event_handler,
                                                        NULL,
                                                        NULL)) ;

    wifi_config_t wifi_config = {
        .ap = {
            .ssid = CONFIG_WIFI_SSID,
            .ssid_len = strlen(CONFIG_WIFI_SSID),
            .channel = CONFIG_WIFI_CHANNEL,
            .password = CONFIG_WIFI_PASSWORD,
            .max_connection = CONFIG_MAX_STA_CONN,
            .authmode = WIFI_AUTH_WPA_WPA2_PSK
        },
    } ;

    if (strlen(CONFIG_WIFI_PASSWORD) == 0)
    {
        wifi_config.ap.authmode = WIFI_AUTH_OPEN ;
    }

    ESP_ERROR_CHECK(esp_wifi_set_mode(WIFI_MODE_AP)) ;
    ESP_ERROR_CHECK(esp_wifi_set_config(ESP_IF_WIFI_AP, &wifi_config)) ;
    ESP_ERROR_CHECK(esp_wifi_start()) ;

    ESP_LOGI(TAG, "wifi_init_softap finished. SSID:%s password:%s channel:%d",
            CONFIG_WIFI_SSID, CONFIG_WIFI_PASSWORD, CONFIG_WIFI_CHANNEL) ;


    // Get default netif object
    esp_netif_t *esp_netif = esp_netif_get_handle_from_ifkey("WIFI_AP_DEF") ;
    if (esp_netif)
    {
        ESP_ERROR_CHECK(esp_netif_get_ip_info(esp_netif,&ap_ip_info)) ;
        strncpy(tcp_server_thread_context.serverIpAddr, ipaddr_ntoa((const ip_addr_t *)&ap_ip_info.ip), 127) ;
        ESP_LOGI(TAG, "local AP address is: %s\n", tcp_server_thread_context.serverIpAddr ) ;
    }

    //strncpy(tcp_server_thread_context.serverIpAddr, ipaddr_ntoa(&gnetif.ip_addr), 127) ;
    //ESP_LOGI(TAG, ipaddr_ntoa(gnetif.ip_addr.addr) )
    //ESP_LOGI(TAG, "local address: %s\n", tcp_server_thread_context.serverIpAddr ) ;

}

#else
/* FreeRTOS event group to signal when we are connected*/
static EventGroupHandle_t s_wifi_event_group ;

/* The event group allows multiple bits for each event, but we only care about two events:
 * - we are connected to the AP with an IP
 * - we failed to connect after the maximum amount of retries */
#define WIFI_CONNECTED_BIT BIT0
#define WIFI_FAIL_BIT      BIT1
#define EXAMPLE_ESP_MAXIMUM_RETRY 10

static int s_retry_num = 0 ;

static void event_handler(void* arg, esp_event_base_t event_base,
                                int32_t event_id, void* event_data)
{
    if (event_base == WIFI_EVENT && event_id == WIFI_EVENT_STA_START)
    {
        esp_wifi_connect() ;
    }
    else if (event_base == WIFI_EVENT && event_id == WIFI_EVENT_STA_DISCONNECTED)
    {
        if (s_retry_num < EXAMPLE_ESP_MAXIMUM_RETRY) {
            esp_wifi_connect();
            s_retry_num++;
            ESP_LOGI(TAG, "retry to connect to the AP") ;
        } else {
            xEventGroupSetBits(s_wifi_event_group, WIFI_FAIL_BIT);
        }
        ESP_LOGI(TAG,"connect to the AP fail") ;
    }
    else if (event_base == IP_EVENT && event_id == IP_EVENT_STA_GOT_IP)
    {
        ip_event_got_ip_t* event = (ip_event_got_ip_t*) event_data;
        strncpy(tcp_server_thread_context.serverIpAddr, ipaddr_ntoa((const ip_addr_t *)&event->ip_info.ip), 127) ;
        ESP_LOGI(TAG, "got ip:" IPSTR, IP2STR(&event->ip_info.ip));
        s_retry_num = 0;
        xEventGroupSetBits(s_wifi_event_group, WIFI_CONNECTED_BIT) ;
    }
}

static void wifi_init(void)
{
    s_wifi_event_group = xEventGroupCreate() ;

    ESP_ERROR_CHECK(esp_netif_init()) ;

    ESP_ERROR_CHECK(esp_event_loop_create_default()) ;
    esp_netif_create_default_wifi_sta() ;

    wifi_init_config_t cfg = WIFI_INIT_CONFIG_DEFAULT() ;
    ESP_ERROR_CHECK(esp_wifi_init(&cfg)) ;

    esp_event_handler_instance_t instance_any_id ;
    esp_event_handler_instance_t instance_got_ip ;
    ESP_ERROR_CHECK(esp_event_handler_instance_register(WIFI_EVENT,
                                                        ESP_EVENT_ANY_ID,
                                                        &event_handler,
                                                        NULL,
                                                        &instance_any_id)) ;
    ESP_ERROR_CHECK(esp_event_handler_instance_register(IP_EVENT,
                                                        IP_EVENT_STA_GOT_IP,
                                                        &event_handler,
                                                        NULL,
                                                        &instance_got_ip)) ;

    wifi_config_t wifi_config = {
        .sta = {
            .ssid = CONFIG_WIFI_SSID,
            .password = CONFIG_WIFI_PASSWORD,
            /* Setting a password implies station will connect to all security modes including WEP/WPA.
             * However these modes are deprecated and not advisable to be used. Incase your Access point
             * doesn't support WPA2, these mode can be enabled by commenting below line */
	     .threshold.authmode = WIFI_AUTH_WPA2_PSK,
            .pmf_cfg = {
                .capable = true,
                .required = false
            },
        },
    };
    ESP_ERROR_CHECK(esp_wifi_set_mode(WIFI_MODE_STA) );
    ESP_ERROR_CHECK(esp_wifi_set_config(ESP_IF_WIFI_STA, &wifi_config) );
    ESP_ERROR_CHECK(esp_wifi_start() );

    ESP_LOGI(TAG, "wifi_init_sta finished.");

    /* Waiting until either the connection is established (WIFI_CONNECTED_BIT) or connection failed for the maximum
     * number of re-tries (WIFI_FAIL_BIT). The bits are set by event_handler() (see above) */
    EventBits_t bits = xEventGroupWaitBits(s_wifi_event_group,
            WIFI_CONNECTED_BIT | WIFI_FAIL_BIT,
            pdFALSE,
            pdFALSE,
            portMAX_DELAY);

    /* xEventGroupWaitBits() returns the bits before the call returned, hence we can test which event actually
     * happened. */
    if (bits & WIFI_CONNECTED_BIT) {
        ESP_LOGI(TAG, "connected to ap SSID:%s password:%s",
                 CONFIG_WIFI_SSID, CONFIG_WIFI_PASSWORD ) ;
    } else if (bits & WIFI_FAIL_BIT) {
        ESP_LOGI(TAG, "Failed to connect to SSID:%s, password:%s",
                 CONFIG_WIFI_SSID, CONFIG_WIFI_PASSWORD ) ;
    } else {
        ESP_LOGE(TAG, "UNEXPECTED EVENT") ;
    }

    /* The event will not be processed after unregister */
    ESP_ERROR_CHECK(esp_event_handler_instance_unregister(IP_EVENT, IP_EVENT_STA_GOT_IP, instance_got_ip));
    ESP_ERROR_CHECK(esp_event_handler_instance_unregister(WIFI_EVENT, ESP_EVENT_ANY_ID, instance_any_id));
    vEventGroupDelete(s_wifi_event_group);
}
#endif


#if CONFIG_EMG8X_BOARD_EMULATION == 0
// send 8bit command
IRAM_ATTR void ad1299_send_cmd8(spi_device_handle_t spi, const uint8_t cmd)
{
    esp_err_t ret ;
    spi_transaction_t t ;
    memset(&t, 0, sizeof(spi_transaction_t)) ;      //Zero out the transaction
    t.flags         = SPI_TRANS_USE_TXDATA ;        //Bitwise OR of SPI_TRANS_* flags
    t.length        = 8 ;                           //Total data length, in bits
    t.user          = (void*)0 ;                    //User-defined variable. Can be used to store eg transaction ID.
    t.tx_data[0]    = cmd ;                         //Pointer to transmit buffer, or NULL for no MOSI phase
    t.rx_buffer     = NULL ;                        //Pointer to receive buffer, or NULL for no MISO phase. Written by 4 bytes-unit if DMA is used.

    int icmd = cmd ;
    ESP_LOGI( TAG, "ad1299_cmd8: send command:0x%02X", icmd ) ;

    ret = spi_device_polling_transmit( spi, &t ) ;  // send command
    if (ret==ESP_OK)
    {
        ESP_LOGI( TAG, "Sent successfuly" ) ;
    }
    ESP_ERROR_CHECK(ret) ;            //Should have had no issues.
}

// Write to ad1299 register
IRAM_ATTR void ad1299_wreg(spi_device_handle_t spi, const uint8_t addr, const uint8_t value)
{
    esp_err_t ret ;
    spi_transaction_t t ;
    memset(&t, 0, sizeof(spi_transaction_t)) ;      //Zero out the transaction
    t.flags         = SPI_TRANS_USE_TXDATA ;        //Bitwise OR of SPI_TRANS_* flags
    t.length        = 8*3 ;                         //Total data length, in bits
    t.user          = (void*)0 ;                    //User-defined variable. Can be used to store eg transaction ID.
    t.tx_data[0]    = AD1299_CMD_WREG|addr ;
    t.tx_data[1]    = 0 ;                           // 1 register to read
    t.tx_data[2]    = value ;                       // value to write
    //t.tx_data[3]    = 0 ;                           // NOP
    t.rx_buffer     = NULL ;                        //Pointer to receive buffer, or NULL for no MISO phase. Written by 4 bytes-unit if DMA is used.

    ESP_LOGI( TAG, "ad1299_wreg :0x%02X to REG:0x%02X", value, addr ) ;
    ret = spi_device_polling_transmit(spi, &t) ;    //Transmit!
    if (ret==ESP_OK)
    {
        ESP_LOGI( TAG, "Sent successfuly" ) ;
    }
    ESP_ERROR_CHECK(ret) ;            //Should have had no issues.
}

IRAM_ATTR uint8_t ad1299_rreg(spi_device_handle_t spi, const uint8_t addr)
{
    esp_err_t ret ;
    spi_transaction_t t ;
    memset( &t, 0, sizeof(spi_transaction_t) ) ;    //Zero out the transaction
    t.flags         = SPI_TRANS_USE_RXDATA|
                      SPI_TRANS_USE_TXDATA ;        //Bitwise OR of SPI_TRANS_* flags
    t.length        = 8*3 ;//8*2 ;                         //Total data length, in bits
    t.rxlength      = 0 ;//8 ;                           //Total data length received, should be not greater than ``length`` in full-duplex mode (0 defaults this to the value of ``length``)
    t.user          = (void*)0 ;                    //User-defined variable. Can be used to store eg transaction ID.

    t.tx_data[0]    = AD1299_CMD_RREG|addr ;
    t.tx_data[1]    = 0 ;                           // 1 register to read
    t.tx_data[2]    = 0 ;                           // NOP
    t.tx_data[3]    = 0 ;                           // NOP

    ret = spi_device_polling_transmit(spi, &t) ;
    if (ret==ESP_OK)
    {
        //ESP_LOGI( TAG, "Read successfuly: 0x%02X", t.rx_data[0] ) ;
        //ESP_LOGI( TAG, "Read successfuly: 0x%02X", t.rx_data[1] ) ;
        //ESP_LOGI( TAG, "Read successfuly: 0x%02X", t.rx_data[2] ) ;
        //ESP_LOGI( TAG, "Read successfuly: 0x%02X", t.rx_data[3] ) ;
    }
    ESP_ERROR_CHECK(ret) ;                          //Should have had no issues.
    ESP_LOGI( TAG, "ad1299_rreg: read from addr:0x%02X -> 0x%02X", addr,t.rx_data[0] ) ;

    return (t.rx_data[0]) ;

}

/*
    ad1299_read_data_block216(spi_device_handle_t spi, uint8_t* data216)
    spi     - spi handle
    data216 - pointer to array of 27 bytes length (216 bits=24bit * 9)
*/
IRAM_ATTR void ad1299_read_data_block216(spi_device_handle_t spi, uint8_t* data216)
{
    esp_err_t ret ;
    spi_transaction_t t ;
    memset( &t, 0, sizeof(spi_transaction_t) ) ;    //Zero out the transaction
    t.flags         = 0 ;                           //Bitwise OR of SPI_TRANS_* flags
    t.length        = phys_block_size ; //216 ;     //Total data length, in bits
    t.rxlength      = phys_block_size ; //216 ;     //Total data length received, should be not greater than ``length`` in full-duplex mode (0 defaults this to the value of ``length``)
    t.user          = (void*)0 ;                    //User-defined variable. Can be used to store eg transaction ID.
    t.tx_buffer     = NULL ;                        // There are No tx data to send
    t.rx_buffer     = data216 ;                     // Pointer to Rx buffer

    ret = spi_device_polling_transmit(spi, &t) ;
    ESP_ERROR_CHECK(ret) ;                          //Should have had no issues.

}

// Rx data buffer for 1 transaction (9*24 bits)
uint8_t rxDataBuf [27] ;

// DRDY signal ISR
// DRDY becomes low when ADS1299 collect 8 samples (1 sample of 24bit for each channel )
// and ready to transfer these data to ESP32 using 1 SPI transaction with 9*24 bits length
IRAM_ATTR static void drdy_gpio_isr_handler(void* arg)
{
    //type_drdy_isr_context* pContext = (type_drdy_isr_context*) arg ;
    static BaseType_t high_task_wakeup = pdFALSE ;

    //xSemaphoreGiveFromISR( pContext->xSemaphore, &high_task_wakeup ) ;

    vTaskNotifyGiveFromISR( datapumpTaskHandle, &high_task_wakeup ) ;

    /* If high_task_wakeup was set to true you
    should yield.  The actual macro used here is
    port specific. */
    if ( high_task_wakeup!=pdFALSE )
    {
        portYIELD_FROM_ISR( ) ;
    }

}
#endif

//
// TCP server task
// This routine is waiting for data appears in ADC queue and
// then send to to connected tcp client(s)
char addr_str[128] ;
void tcp_server_task( void* pvParameter )
{

    // This routine is based on https://github.com/sankarcheppali/esp_idf_esp32_posts/blob/master/tcp_server/sta_mode/main/esp_sta_tcp_server.c

    type_tcp_server_thread_context* pTcpServerContext   = (type_tcp_server_thread_context*) pvParameter ;

    struct sockaddr_in tcpServerAddr ;
    tcpServerAddr.sin_addr.s_addr                       = htonl( INADDR_ANY ) ;
    tcpServerAddr.sin_family                            = AF_INET ;
    tcpServerAddr.sin_port                              = htons( CONFIG_EMG8X_TCP_SERVER_PORT ) ;
    int s ;
    static struct sockaddr_in remote_addr ;
    static long unsigned int socklen ;
    socklen = sizeof(remote_addr) ;
    int cs ; //client socket

    //xEventGroupWaitBits(wifi_event_group,CONNECTED_BIT,false,true,portMAX_DELAY) ;

    while(1)
    {
        s = socket( AF_INET, SOCK_STREAM, 0) ;
        if(s < 0)
        {
            ESP_LOGE(TAG, "TCP_SERVER: Failed to allocate socket.\n") ;
            vTaskDelay(1000 / portTICK_PERIOD_MS) ;
            continue ;
        }

        if(bind(s, (struct sockaddr *)&tcpServerAddr, sizeof(tcpServerAddr)) != 0)
        {
            ESP_LOGE(TAG, "TCP_SERVER: socket bind failed errno=%d \n", errno) ;
            close(s) ;
            vTaskDelay(4000 / portTICK_PERIOD_MS) ;
            continue ;
        }

        if(listen (s, 1024) != 0)
        {
            ESP_LOGE(TAG, "TCP_SERVER: socket listen failed errno=%d \n", errno) ;
            close(s) ;
            vTaskDelay(4000 / portTICK_PERIOD_MS) ;
            continue ;
        }

        ESP_LOGI(TAG,"TCP server started at %s, listen on the port: %d, at CpuCore%1d\n", pTcpServerContext->serverIpAddr, CONFIG_EMG8X_TCP_SERVER_PORT, xPortGetCoreID() ) ;

        // data transfer cycle
        while(1)
        {
            cs  =   accept(s,(struct sockaddr *)&remote_addr, &socklen) ;

            inet_ntoa_r(remote_addr.sin_addr.s_addr, addr_str, sizeof(addr_str) - 1) ;
            ESP_LOGI(TAG,"New incoming connection from: %s\n", addr_str ) ;

            while(1)
            {
                if(xSemaphoreTake(drdy_thread_context.headTailMutex, portMAX_DELAY ) == pdTRUE) 
                {
                    if (drdy_thread_context.tail != drdy_thread_context.head)
                    {
                        xSemaphoreGive(drdy_thread_context.headTailMutex) ;
                        if( write(cs , drdy_thread_context.adcDataQue[drdy_thread_context.tail],
                            ((CONFIG_EMG8X_TRANSPORT_BLOCK_HEADER_SIZE)/sizeof(int32_t)+(AD1299_NUM_CH+1)*(CONFIG_EMG8X_SAMPLES_PER_TRANSPORT_BLOCK))*sizeof(int32_t)) < 0)
                        {
                            ESP_LOGE(TAG, "TCP_SERVER: Send failed\n") ;
                            break ;
                        }

                        ESP_LOGI(TAG, "TCP_SERVER: Block %d Sent.", (int)drdy_thread_context.adcDataQue[drdy_thread_context.tail][CONFIG_EMG8X_PKT_COUNT_OFFSET] ) ;
                        
                        if(xSemaphoreTake(drdy_thread_context.headTailMutex, portMAX_DELAY ) == pdTRUE) 
                        {
                            // move queue tail forward
                            drdy_thread_context.tail        = (drdy_thread_context.tail+1)%(CONFIG_EMG8X_TRANSPORT_QUE_SIZE) ;
                            xSemaphoreGive(drdy_thread_context.headTailMutex) ;
                        }
                        else
                        {
                            ESP_LOGE(TAG, "TCP_SERVER: can't take headTailMutex") ;
                        }
                    }
                    else
                    {
                        xSemaphoreGive(drdy_thread_context.headTailMutex) ;
                    }
                }
                else
                {
                    ESP_LOGE(TAG, "TCP_SERVER: can't take headTailMutex") ;
                }

                //taskYIELD() ;

                // Notify or/and wait for data appears in the queue
                //if ( xSemaphoreTake( drdy_thread_context.xDataQueueSemaphore, 0xFFFF ) != pdTRUE )
                //if (!ulTaskNotifyTake( pdFALSE, 0xffff )) // Wait or/and decrement count
                //{
                //    // still waiting for data from the ADC
                //    ESP_LOGE(TAG, "TCP_SERVER: There are no data from ADC for a long time...\n") ;
                //    continue ;
                //}

            }

            inet_ntoa_r(remote_addr.sin_addr.s_addr, addr_str, sizeof(addr_str) - 1) ;
            ESP_LOGI(TAG, "Close connection to %s\n", addr_str ) ;

            close(cs) ;

            vTaskDelay( 500 / portTICK_PERIOD_MS) ;
        }
    }

}

static void emg8x_app_start(void)
{
#if CONFIG_EMG8X_BOARD_EMULATION==0
//    int dmaChan             = 0 ;  // disable dma
    esp_err_t ret           = 0 ;

    ESP_LOGI(TAG, "Initialize GPIO lines") ;

    // Initialize GPIO pins



    gpio_reset_pin( AD1299_PWDN_PIN ) ;
    gpio_set_direction( AD1299_PWDN_PIN, GPIO_MODE_OUTPUT ) ;

    gpio_reset_pin( AD1299_RESET_PIN ) ;
    gpio_set_direction( AD1299_RESET_PIN, GPIO_MODE_OUTPUT ) ;

    gpio_reset_pin( AD1299_START_PIN ) ;
    gpio_set_direction( AD1299_START_PIN, GPIO_MODE_OUTPUT ) ;

    gpio_reset_pin( AD1299_DRDY_PIN ) ;
    gpio_set_direction( AD1299_DRDY_PIN, GPIO_MODE_INPUT ) ;
    gpio_set_intr_type( AD1299_DRDY_PIN, GPIO_INTR_NEGEDGE ) ;
    gpio_intr_enable( AD1299_DRDY_PIN ) ;

    // Debug pin
    //gpio_reset_pin( DEBUG_PIN1 ) ;
    //gpio_set_direction( DEBUG_PIN1, GPIO_MODE_OUTPUT ) ;
    //gpio_set_level( DEBUG_PIN1,     0 ) ;

    // See 10.1.2 Setting the Device for Basic Data Capture (ADS1299 Datasheet)
    ESP_LOGI(TAG, "Set PWDN & RESET to 1") ;
    gpio_set_level(AD1299_PWDN_PIN,     1 ) ;
    gpio_set_level(AD1299_RESET_PIN,    1 ) ;
    gpio_set_level(AD1299_START_PIN,    1 ) ;

    ESP_LOGI(TAG, "Wait for 2^18 tclk") ;

    vTaskDelay( 500 / portTICK_PERIOD_MS ) ;
    //ets_delay_us( 15*10 ) ; //~30 clock periods @2MHz

    // Reset pulse
    ESP_LOGI(TAG, "Reset ad129x") ;
    gpio_set_level(AD1299_RESET_PIN, 0 ) ;
    vTaskDelay( 300 / portTICK_PERIOD_MS ) ;
    //ets_delay_us( 15*10 ) ;  //~20 clock periods @2MHz - This delay does not works, it is not enough for reset
    gpio_set_level(AD1299_RESET_PIN, 1 ) ;

    vTaskDelay( 500 / portTICK_PERIOD_MS ) ;

    ESP_LOGI(TAG, "Initialize SPI driver...") ;
    // SEE esp-idf/components/driver/include/driver/spi_common.h
    spi_bus_config_t buscfg = {
        .miso_io_num        = GPIO_NUM_13,
        .mosi_io_num        = GPIO_NUM_11,
        .sclk_io_num        = GPIO_NUM_12,
        .quadwp_io_num      = -1,
        .quadhd_io_num      = -1,
        .flags              = 0,                        // Abilities of bus to be checked by the driver. Or-ed value of ``SPICOMMON_BUSFLAG_*`` flags.
        .intr_flags         = ESP_INTR_FLAG_IRAM,
        .max_transfer_sz    = 0                         // maximum data size in bytes, 0 means 4094
    } ;

    // see esp-idf/components/driver/include/driver/spi_master.h
    spi_device_interface_config_t devcfg = {
        .command_bits       = 0,                        // 0-16
        .address_bits       = 0,                        // 0-64
        .dummy_bits         = 0,                        // Amount of dummy bits to insert between address and data phase
        .clock_speed_hz     = 1000000,                  // Clock speed, divisors of 80MHz, in Hz. See ``SPI_MASTER_FREQ_*``.
        .mode               = 1,                        // SPI mode 0
        .input_delay_ns     = 0,                        // The time required between SCLK and MISO
        .spics_io_num       = GPIO_NUM_10,              // CS pin
        .queue_size         = 1,                        // No queued transactions
        .cs_ena_pretrans    = 0,                        // 0 not used
        .cs_ena_posttrans   = 0,                        // 0 not used
    } ;

    //Initialize the SPI bus
    ret                     = spi_bus_initialize(SPI2_HOST, &buscfg, SPI_DMA_CH_AUTO ) ;
    ESP_ERROR_CHECK(ret) ;
    //Attach the LCD to the SPI bus
    ret                     = spi_bus_add_device(SPI2_HOST, &devcfg, &spi_dev ) ;
    ESP_ERROR_CHECK(ret) ;
    ESP_LOGI(TAG, "SPI driver initialized, Freq limit is:%dHz", (int)spi_get_freq_limit( false, 0 ) ) ;


    // Send SDATAC / Stop Read Data Continuously Mode
    ESP_LOGI(TAG, "Send SDATAC") ;

    gpio_set_level(AD1299_START_PIN,    0 ) ;
    //while(true)
    //{
    ad1299_send_cmd8( spi_dev, AD1299_CMD_SDATAC ) ;
    vTaskDelay( 100 / portTICK_PERIOD_MS ) ;
    //}

    /*

    ESP_LOGI(TAG, "Read chip Id from Reg#0: 0x%02x", ad1299_rreg( spi_dev, AD1299_ADDR_ID ) ) ;

    ad1299_send_cmd8( spi_dev, AD1299_CMD_RDATAC ) ;

    gpio_set_level(AD1299_START_PIN, 1 ) ;

    // Install ISR for all GPIOs
    gpio_install_isr_service(0) ;

    // Configure ISR for DRDY signal
    drdy_isr_context.xSemaphore                     = xSemaphoreCreateBinary() ;
    gpio_isr_handler_add( AD1299_DRDY_PIN, drdy_gpio_isr_handler, &drdy_isr_context ) ;

    while(1)
    {

        // Wait for DRDY
        //while( gpio_get_level(AD1299_DRDY_PIN)==1 ) { vTaskDelay( 1  ) ;}
        if( xSemaphoreTake( drdy_isr_context.xSemaphore, 0xffff ) == pdTRUE )
        {

            // DRDY goes down - data ready to read
            ad1299_read_data_block216( spi_dev, drdy_thread_context.spiReadBuffer ) ;
        }
    }
    */


    // RREG id
    // ID Control register format:
    // 7 6 5 4 3 2 1 0
    // 1 0 0 1 0 x x x  - ADS129x device family
    // 1 1 0 1 0 x x x  - ADS129xR device family
    // ? ? ? 1 1 1 x x  - ADS1299-x device family 

    uint8_t value8              = ad1299_rreg( spi_dev, AD1299_ADDR_ID ) ;
    ESP_LOGI(TAG, "Read chip Id from Reg#0: 0x%02X", value8) ;


    uint8_t ads_check_bit    = (value8>>4) & 0x01 ;
    uint8_t ads_family_bit   = (value8>>3) & 0x01 ;

    if ( ads_check_bit && ads_family_bit )
    {        
        uint8_t ad1299_rev_id       =  value8>>5 ;
        uint8_t ad1299_dev_id       = (value8>>2) & 0x03 ;
        uint8_t ad1299_num_ch       = (value8) & 0x03 ;

        ESP_LOGI(TAG,"ads1299-x found:") ;
        ESP_LOGI(TAG, "!-->ad1299_rev_id:       0x%02X",  ad1299_rev_id ) ;
        ESP_LOGI(TAG, "!-->ad1299_check_bit:    %1d (should be 1)",  ads_check_bit ) ;
        ESP_LOGI(TAG, "!-->ad1299_dev_id:       0x%02X",  ad1299_dev_id ) ;
        ESP_LOGI(TAG, "!-->ad1299_num_ch:       0x%02X",  ad1299_num_ch ) ;
        if (ad1299_num_ch==0)
        {
            num_phys_channels = 4 ;
        }
        else if (ad1299_num_ch==1)
        {
            num_phys_channels = 6 ;
        }
        else if (ad1299_num_ch==2)
        {
            num_phys_channels = 8 ;
        }
        else
        {
            ESP_LOGE(TAG, "error: ubnormal ad129x_num_ch!" ) ;
            return ;
        }
    }
    else if (ads_check_bit)
    {
        uint8_t ad129x_num_ch       = (value8) & 0x07 ;
        ESP_LOGI(TAG,"ADS129x found:") ;
        ESP_LOGI(TAG, "!-->ad129x_num_ch:       0x%02X",  ad129x_num_ch ) ;
        if (ad129x_num_ch==0)
        {
            num_phys_channels = 4 ;
        }
        else if (ad129x_num_ch==1)
        {
            num_phys_channels = 6 ;
        }
        else if (ad129x_num_ch==2)
        {
            num_phys_channels = 8 ;
        }
        else
        {
            ESP_LOGE(TAG, "error: ubnormal ad129x_num_ch!" ) ;
            return ;
        }
    }
    else
    {
        ESP_LOGE(TAG, "error: ads1299-x, ads129x not found!" ) ;
        return ;
    }

    phys_block_size = 24*(num_phys_channels+1) ;

    ESP_LOGI(TAG, "num_phys_channels: %d", num_phys_channels ) ;
    ESP_LOGI(TAG, "phys_block_size: %d bits", phys_block_size ) ;


    gpio_set_level( ESP_LED1,     1 ) ;


    // Set internal reference
    // WREG CONFIG3 E0h
    ESP_LOGI(TAG, "Set internal reference" ) ;
    ad1299_wreg( spi_dev, AD1299_ADDR_CONFIG3, 0xEE ) ;
    vTaskDelay( 100 / portTICK_PERIOD_MS ) ;

 /*   while(1)
    {
        uint8_t reg_value = ad1299_rreg( spi_dev, AD1299_ADDR_CONFIG3 ) ;
        ESP_LOGI(TAG, "check CONF3:       0x%02X",  reg_value ) ;
        vTaskDelay( 500 / portTICK_PERIOD_MS ) ;
    }*/

    //Set device for DR=fmod/4096
    // Enable clk output
    ESP_LOGI(TAG, "Set sampling rate" ) ;
    ad1299_wreg( spi_dev, AD1299_ADDR_CONFIG1, 0xf6 ) ;     // 0xf4 for 1299-x
    vTaskDelay( 100 / portTICK_PERIOD_MS ) ;

    // Configure test signal parameters
    ad1299_wreg( spi_dev, AD1299_ADDR_CONFIG2, 0xb5 ) ;
    vTaskDelay( 100 / portTICK_PERIOD_MS ) ;

    // Configure test signal parameters
    ad1299_wreg( spi_dev, AD1299_ADDR_LEADOFF, 0x0e ) ;
    vTaskDelay( 100 / portTICK_PERIOD_MS ) ;

    // Set All Channels to Input Short
    for (int i=0;i<8;i++)
    {
        ad1299_wreg( spi_dev, AD1299_ADDR_CH1SET+i, 0x01 ) ;
        //vTaskDelay( 50 / portTICK_PERIOD_MS ) ;
    }
    vTaskDelay( 50 / portTICK_PERIOD_MS ) ;

    // Activate Conversion
    // After This Point DRDY Toggles at
    // fCLK / 8192
    gpio_set_level(AD1299_START_PIN, 1 ) ;
    vTaskDelay( 50 / portTICK_PERIOD_MS ) ;

    // Put the Device Back in RDATAC Mode
    // RDATAC
    ad1299_send_cmd8( spi_dev, AD1299_CMD_RDATAC ) ;
    vTaskDelay( 50 / portTICK_PERIOD_MS ) ;

    // Capture data and check for noise level
    for(int nSample=0;nSample<CONFIG_EMG8X_SAMPLES_PER_TRANSPORT_BLOCK;nSample++)
    {

        // Wait for DRDY
        while( gpio_get_level(AD1299_DRDY_PIN)==1 ) { vTaskDelay( 1  ) ;}

        // DRDY goes down - data ready to read
        ad1299_read_data_block216( spi_dev, rxDataBuf ) ;

        ESP_LOGI(TAG, "DATA: STAT:0x%02X%02X%02X DATA1:0x%02X%02X%02X",  rxDataBuf[0],rxDataBuf[1],rxDataBuf[2], rxDataBuf[3],rxDataBuf[4],rxDataBuf[5] ) ;

        // Place here code to collect samples and analyse noise level for
        // shorted analog inputs

        vTaskDelay( 1 ) ;

    }

    // Stop all the channels
    ad1299_send_cmd8( spi_dev, AD1299_CMD_SDATAC ) ;
    vTaskDelay( 100 / portTICK_PERIOD_MS ) ;

    // Configure channels
    ad1299_wreg( spi_dev, AD1299_ADDR_CH1SET, 0x40 ) ;      // CH1: Test signal,    PGA_Gain=1
    ad1299_wreg( spi_dev, AD1299_ADDR_CH2SET, 0x30 ) ;      // CH2: Measure VDD,    PGA_Gain=1
    ad1299_wreg( spi_dev, AD1299_ADDR_CH3SET, 0x30 ) ;      // CH3: Normal,         PGA_Gain=1
    ad1299_wreg( spi_dev, AD1299_ADDR_CH4SET, 0x00 ) ;      // CH4: Normal,         PGA_Gain=24
    ad1299_wreg( spi_dev, AD1299_ADDR_CH5SET, 0x30 ) ;      // CH5: Normal,         PGA_Gain=24
    ad1299_wreg( spi_dev, AD1299_ADDR_CH6SET, 0x50 ) ;      // CH6: Normal,         PGA_Gain=24
    ad1299_wreg( spi_dev, AD1299_ADDR_CH7SET, 0x30 ) ;      // CH7: Normal,         PGA_Gain=24
    ad1299_wreg( spi_dev, AD1299_ADDR_CH8SET, 0x30 ) ;      // CH8: Normal,         PGA_Gain=24
    vTaskDelay( 50 / portTICK_PERIOD_MS ) ;

    ESP_LOGI(TAG, "Put device in RDATAC mode" ) ;

    // Put the Device Back in RDATAC Mode
    // RDATAC
    ad1299_send_cmd8( spi_dev, AD1299_CMD_RDATAC ) ;
    vTaskDelay( 50 / portTICK_PERIOD_MS ) ;

#endif // Emulation

    // Initialize drdy_thread_context
    drdy_thread_context.head                        = 0 ;
    drdy_thread_context.tail                        = 0 ;
    drdy_thread_context.sampleCount                 = 0 ;
    drdy_thread_context.blockCounter                = 0 ;

    // Initialize counting semaphore which represents number of queued blocks
    drdy_thread_context.xDataQueueSemaphore         = xSemaphoreCreateCounting( CONFIG_EMG8X_TRANSPORT_QUE_SIZE, 0 ) ;
    drdy_thread_context.headTailMutex  = xSemaphoreCreateMutex() ;

    for (int iQue=0;iQue<CONFIG_EMG8X_TRANSPORT_QUE_SIZE;iQue++)
    {

        unsigned char* pTransportBlockHeader        = (unsigned char*) drdy_thread_context.adcDataQue[iQue] ;

        // Fill in each header
        memset( pTransportBlockHeader, 0, CONFIG_EMG8X_TRANSPORT_BLOCK_HEADER_SIZE ) ;

        // Sync 5 bytes
        strncpy( (char*)pTransportBlockHeader, "EMG8x", 6 ) ;

        // Initialize packet counter
        drdy_thread_context.adcDataQue[iQue][CONFIG_EMG8X_PKT_COUNT_OFFSET]     = 0 ;

    }

    // Initialize tcp_server_thread_context
    tcp_server_thread_context.pDrdyThreadContext    = &drdy_thread_context ;

    // Start TCP server task
    //xTaskCreatePinnedToCore( &tcp_server_task, "tcp_server_task", 4096, &tcp_server_thread_context, 5, NULL, 0 ) ;
    /*https://github.com/espressif/esp-idf/blob/0bbc721a633f9afe4f3ebe648b9ca99e2f2f6d5f/components/freertos/include/freertos/task.h*/
    //xTaskCreate( &tcp_server_task, "tcp_server_task", 4096, &tcp_server_thread_context, tskIDLE_PRIORITY+5, &tcpTaskHandle ) ;

    // !!!
    // Data pump task and TCP task should be pinned to different cores to prevent influence of TCP to realtime data pump procedures

    // Start TCP task on Core#0
    xTaskCreatePinnedToCore( &tcp_server_task, "tcp_server_task", 4096, &tcp_server_thread_context, tskIDLE_PRIORITY+5, &tcpTaskHandle, 0 ) ;
    configASSERT( tcpTaskHandle ) ;

    // Start Data pump task on Core#1
    xTaskCreatePinnedToCore( &spi_data_pump_task, "spi_data_pump_task", 4096, &tcp_server_thread_context, tskIDLE_PRIORITY+5, &datapumpTaskHandle, 1 ) ;
    configASSERT( datapumpTaskHandle ) ;

#if CONFIG_EMG8X_BOARD_EMULATION==0
    // ISR uses datapumpTaskHandle to deliver notification

    // Install ISR for all GPIOs
    gpio_install_isr_service(0) ;

    // Configure ISR for DRDY signal
    drdy_isr_context.xSemaphore                     = xSemaphoreCreateBinary() ;
    gpio_isr_handler_add( AD1299_DRDY_PIN, drdy_gpio_isr_handler, &drdy_isr_context ) ;

#endif


}

#if CONFIG_EMG8X_BOARD_EMULATION
int numSamplesToMilliseconds(int numSamples)
{
    int sampleRate  = 16000/(1<<CONFIG_EMG8X_ADC_SAMPLING_FREQUENCY) ;
    return (1000*numSamples/sampleRate) ;
}
#endif

//float my_data_array[4096] ;
//int32_t sampleCounter = 0 ;

IRAM_ATTR void spi_data_pump_task( void* pvParameter )
{
    ESP_LOGI(TAG,"spi_data_pump_task started at CpuCore%1d\n", xPortGetCoreID() ) ;

    // Queue full flag
    int queueFull                                   = 0 ;

    // Continuous capture the data
    while(1)
    {

        // Wait for DRDY
        //while( gpio_get_level(AD1299_DRDY_PIN)==1 ) { vTaskDelay( 1  ) ;}
#if CONFIG_EMG8X_BOARD_EMULATION
        if (drdy_thread_context.sampleCount%60==0)
        {
            vTaskDelay( numSamplesToMilliseconds(60)/ portTICK_PERIOD_MS ) ;
        }
#else

        // Wait for DRDY signal becomes low
        if (gpio_get_level(AD1299_DRDY_PIN)!=0)
        {
            ESP_LOGE(TAG, "spi_data_pump_task: there is no data!" ) ;
            if (!ulTaskNotifyTake( pdTRUE, 20 ))
            {
                // Data is not ready
                ESP_LOGE(TAG, "spi_data_pump_task: continue" ) ;
                continue ;
            }
        }

        // Wait using semaphore
        //if( gpio_get_level(AD1299_DRDY_PIN)==0 xSemaphoreTake( drdy_isr_context.xSemaphore, 0xffff )==pdTRUE )

#endif

        //gpio_set_level( DEBUG_PIN1,     1 ) ;
#if CONFIG_EMG8X_BOARD_EMULATION
        drdy_thread_context.spiReadBuffer[0] = 0xc0 ;
#else
        // Read data from device
        ad1299_read_data_block216( spi_dev, drdy_thread_context.spiReadBuffer ) ;
#endif
        //gpio_set_level( DEBUG_PIN1,     0 ) ;

        // Check for stat 0xCx presence
        if ((drdy_thread_context.spiReadBuffer[0]&0xf0)!=0xc0)
        {
            ESP_LOGE(TAG, "spi_data_pump_task: [%6d][%6d] 0xc0 not found!", (int)drdy_thread_context.blockCounter, (int)drdy_thread_context.sampleCount ) ;

            ad1299_send_cmd8( spi_dev, AD1299_CMD_SDATAC ) ;
            vTaskDelay( 100 / portTICK_PERIOD_MS ) ;

            ad1299_send_cmd8( spi_dev, AD1299_CMD_RDATAC ) ;
            vTaskDelay( 50 / portTICK_PERIOD_MS ) ;

            continue ;
        }

        //gpio_set_level( DEBUG_PIN1,     1 ) ;
        // get STAT field
        // transform 24 bit field to 32 bit integer
        drdy_thread_context.adcStat32   = (uint32_t) (
                                                        (((uint32_t)drdy_thread_context.spiReadBuffer[0])<<16) |
                                                        (((uint32_t)drdy_thread_context.spiReadBuffer[1])<<8) |
                                                        ((uint32_t) drdy_thread_context.spiReadBuffer[2])
                                                    ) ;

        // save STAT field to transport block
        drdy_thread_context.adcDataQue[drdy_thread_context.head][
            (CONFIG_EMG8X_TRANSPORT_BLOCK_HEADER_SIZE)/sizeof(int32_t) +
            drdy_thread_context.sampleCount ] = drdy_thread_context.adcStat32 ;

        // transform 24 bit twos-complement samples to 32 bit signed integers
        // save 32 bit samples into thread queue drdy_thread_context
        for(int chNum=0;chNum<AD1299_NUM_CH;chNum++)
        {

            uint32_t signExtBits        = 0x00000000 ;

            int byteOffsetCh            = (chNum+1)*3 ; // offset in raw data to first byte of 24 twos complement field

            if (drdy_thread_context.spiReadBuffer[ byteOffsetCh ] & 0x80)
            {
                // extend sign bit to 31..24
                signExtBits             = 0xff000000 ;
            }

            int32_t value_i32           =
                                        (int32_t) (
                                                        signExtBits |
                                                        (((uint32_t)drdy_thread_context.spiReadBuffer[byteOffsetCh])<<16) |
                                                        (((uint32_t)drdy_thread_context.spiReadBuffer[byteOffsetCh+1])<<8) |
                                                        ((uint32_t) drdy_thread_context.spiReadBuffer[byteOffsetCh+2])
                                                    ) ;
#if CONFIG_EMG8X_BOARD_EMULATION
            value_i32                   = (drdy_thread_context.sampleCount%20)<10 ;
#endif

            drdy_thread_context.adcDataQue[drdy_thread_context.head][
                (CONFIG_EMG8X_TRANSPORT_BLOCK_HEADER_SIZE)/sizeof(int32_t) +
                (CONFIG_EMG8X_SAMPLES_PER_TRANSPORT_BLOCK)*(chNum+1) +
                drdy_thread_context.sampleCount
                ]    = value_i32 ;
        } //for(int chNum=0
        //gpio_set_level( DEBUG_PIN1,     0 ) ;

        drdy_thread_context.sampleCount++ ;

        if (drdy_thread_context.sampleCount>=CONFIG_EMG8X_SAMPLES_PER_TRANSPORT_BLOCK)
        {
            // Transport block collection done

            // reset sample counter of transport block
            drdy_thread_context.sampleCount     = 0 ;

            // put packet counter to transport header
            drdy_thread_context.adcDataQue[drdy_thread_context.head][CONFIG_EMG8X_PKT_COUNT_OFFSET] = drdy_thread_context.blockCounter ;

            if(xSemaphoreTake(drdy_thread_context.headTailMutex, portMAX_DELAY ) == pdTRUE) 
            {
                if ( (drdy_thread_context.head+1)%(CONFIG_EMG8X_TRANSPORT_QUE_SIZE)!=drdy_thread_context.tail )
                {
                    drdy_thread_context.head = (drdy_thread_context.head+1)%(CONFIG_EMG8X_TRANSPORT_QUE_SIZE) ;
                }
                else
                {
                    ESP_LOGE(TAG, "spi_data_pump_task: FIFO Full @ block %d\n", (int)drdy_thread_context.blockCounter ) ;
                }
                xSemaphoreGive(drdy_thread_context.headTailMutex) ;
            }
            else
            {
                ESP_LOGE(TAG, "spi_data_pump_task: can't take headTailMutex" ) ;
            }

            // if (!queueFull)
            // {
            //     // Send notification to TCP server task and increment taskCounter
            //     uint32_t taskCounterValueBeforeIncrement  = 0 ;
            //     xTaskNotifyAndQuery( tcpTaskHandle, 0, eIncrement, &taskCounterValueBeforeIncrement ) ;
            //     if ((taskCounterValueBeforeIncrement+1)==CONFIG_EMG8X_TRANSPORT_QUE_SIZE)
            //     {
            //         // Queue is over!
            //         // Do not move head forward - wait for TCP server sends data to host
            //         ESP_LOGE(TAG, "ADC_READ_CYCLE: TCP FIFO Full @ block %d\n", (int)drdy_thread_context.blockCounter ) ;
            //         queueFull = 1 ;
            //     }
            //     else
            //     {
            //         // There is empty space in the queue
            //         // move queue head forward
            //         drdy_thread_context.head        = (drdy_thread_context.head+1)%(CONFIG_EMG8X_TRANSPORT_QUE_SIZE) ;
            //     }

            // }
            // else
            // {
            //     // check for queue state
            //     uint32_t taskCounterValue  = 0 ;
            //     xTaskNotifyAndQuery( tcpTaskHandle, 0, eNoAction, &taskCounterValue ) ;
            //     if ((taskCounterValue+1)<CONFIG_EMG8X_TRANSPORT_QUE_SIZE)
            //     {
            //         ESP_LOGI(TAG, "ADC_READ_CYCLE: TCP FIFO ok @ block %d\n", (int)drdy_thread_context.blockCounter ) ;
            //         queueFull = 0 ;
            //     }
            // }

/*
            //if (xSemaphoreGive( drdy_thread_context.xDataQueueSemaphore )==pdTRUE)
            if ( !queueFull )
            {

                // move queue head forward
                drdy_thread_context.head        = (drdy_thread_context.head+1)%(CONFIG_EMG8X_TRANSPORT_QUE_SIZE) ;

                if (queueFull)
                {
                    ESP_LOGI(TAG, "ADC_READ_CYCLE: TCP FIFO ok @ block %d\n", drdy_thread_context.blockCounter ) ;
                    queueFull = 0 ;
                }
            }
            else
            {
                // There is no space in queue
                // skip data
                if (!queueFull)
                {
                    ESP_LOGE(TAG, "ADC_READ_CYCLE: TCP FIFO Full @ block %d\n", drdy_thread_context.blockCounter ) ;
                    queueFull = 1 ;
                }
            }
            */
            //gpio_set_level( DEBUG_PIN1,     0 ) ;

            // Increment received packet counter
            drdy_thread_context.blockCounter += 1 ;

            //ESP_LOGI(TAG, "head: %d",  drdy_thread_context.head ) ;
        }
    }
}

void app_main()
{
    ESP_LOGI(TAG, "[APP] Startup..") ;
    ESP_LOGI(TAG, "[APP] Free memory: %d bytes", (int)esp_get_free_heap_size()) ;
    ESP_LOGI(TAG, "[APP] IDF version: %s", esp_get_idf_version()) ;

    esp_chip_info_t chip_info ;
    memset(&chip_info,0,sizeof(esp_chip_info_t)) ;
    esp_chip_info(&chip_info) ;
    switch(chip_info.model)
    {
        case CHIP_ESP32:
            ESP_LOGI(TAG, "[APP] Processor model: ESP32") ;
            break ;
        case CHIP_ESP32S2:
            ESP_LOGI(TAG, "[APP] Processor model: ESP32-S2") ;
            break ;
/*
        case CHIP_ESP32S3:
            ESP_LOGI(TAG, "[APP] Processor model: ESP32-S3") ;
            break ;
        case CHIP_ESP32C3:
            ESP_LOGI(TAG, "[APP] Processor model: ESP32-C3") ;
            break ;
*/
        default:
            ESP_LOGI(TAG, "[APP] Processor model: Unknown(%d)",(int)chip_info.model) ;
            break ;
    }
    ESP_LOGI(TAG, "[APP] Processor num cores: %d",(int)chip_info.cores) ;

    //esp_log_level_set("*", ESP_LOG_INFO);
    //esp_log_level_set("TRANSPORT_TCP", ESP_LOG_VERBOSE);
    //esp_log_level_set("TRANSPORT_SSL", ESP_LOG_VERBOSE);
    //esp_log_level_set("TRANSPORT", ESP_LOG_VERBOSE);
    //esp_log_level_set("OUTBOX", ESP_LOG_VERBOSE);

    //Initialize NVS
    esp_err_t ret = nvs_flash_init() ;
    if (ret == ESP_ERR_NVS_NO_FREE_PAGES || ret == ESP_ERR_NVS_NEW_VERSION_FOUND)
    {
      ESP_ERROR_CHECK(nvs_flash_erase()) ;
      ret = nvs_flash_init() ;
    }
    ESP_ERROR_CHECK(ret) ;

#if CONFIG_EMG8X_BOARD_REV == 4
    gpio_reset_pin( BOARD_LED1 ) ;
    gpio_reset_pin( BOARD_LED2 ) ;
    gpio_reset_pin( BOARD_LED3 ) ;

    gpio_set_direction( BOARD_LED1, GPIO_MODE_OUTPUT ) ;
    gpio_set_direction( BOARD_LED2, GPIO_MODE_OUTPUT ) ;
    gpio_set_direction( BOARD_LED3, GPIO_MODE_OUTPUT ) ;

    gpio_set_level( BOARD_LED1,     0 ) ;
    gpio_set_level( BOARD_LED2,     0 ) ;
    gpio_set_level( BOARD_LED3,     0 ) ;
#endif

    gpio_reset_pin( ESP_LED1 ) ;
    gpio_set_direction( ESP_LED1, GPIO_MODE_OUTPUT ) ;
    gpio_set_level( ESP_LED1,     0 ) ;


#if CONFIG_WIFI_MODE_SOFTAP
    wifi_init_softap() ;
#else
    wifi_init() ;
#endif
    emg8x_app_start() ;
}
