RF-Lab/emg-lab/(commit log)

2025-06-11 Add files via upload
    Пучков К. Д. ВКР
2025-07-31 myocell_s3 project added
    [adc_8.kicad_sch, cpu_wroom_esp32.kicad_sch, myocell_s3.kicad_pcb, myocell_s3.kicad_sch, power_supply.kicad_sch, usb.kicad_sch]
2025-09-01 recovery commit
    [adc_8.kicad_sch, cpu_wroom_esp32.kicad_sch, myocell_s3.kicad_pcb, myocell_s3.kicad_sch, power_supply.kicad_sch, usb.kicad_sch]
2025-10-09 working on schematic
    [adc_8.kicad_sch, cpu_wroom_esp32.kicad_sch, myocell_s3.kicad_sch]
2025-11-21 working on schematic transfer
    [cpu_wroom_esp32.kicad_sch, myocell_s3.kicad_pcb, myocell_s3.kicad_sch]
2025-12-05 RLDINV still unconnected
    [adc_8.kicad_sch, cpu_wroom_esp32.kicad_sch, myocell_s3.kicad_sch, power_supply.kicad_sch]
2025-12-09 MSS22D18 slider switch added
    [myocell_s3.kicad_sch, power_supply.kicad_sch]
2025-12-17 schematic and footprints done
    [adc_8.kicad_sch, myocell_s3.kicad_pcb, myocell_s3.kicad_sch, power_supply.kicad_sch]
2025-12-18 working on component placement
    [myocell_s3.kicad_pcb, myocell_s3.kicad_sch]
2025-12-24 working on part placement
    [myocell_s3.kicad_pcb]
2025-12-24 scheme main table updated
    [myocell_s3.kicad_sch]
2025-12-31 amg analog interface model added
    [emg_filter.kicad_pcb, emg_filter.kicad_sch]
2025-12-31 working on pcb parts placement
    [myocell_s3.kicad_pcb]
2026-01-01 dif signal filter updated
    [ADS1298RECG_FE_filter.kicad_sch, emg-lab-passive-filter-dif-1.kicad_sch, emg_filter.kicad_sch]
2026-01-02 emg filters updated
    [myocell_s3.kicad_pcb, myocell_s3.kicad_sch]
2026-01-03 working on parts placement
    [adc_8.kicad_sch, myocell_s3.kicad_pcb, power_supply.kicad_sch]
2026-01-03 add transient settings
    [emg-lab-passive-filter-dif-1.kicad_sch]
2026-01-11 working on components placement
    [myocell_s3.kicad_pcb]
2026-01-11 schematic updated: channels 3,4 is onboard now
    [adc_8.kicad_sch, myocell_s3.kicad_pcb, myocell_s3.kicad_sch]
2026-01-20 components placement
    [myocell_s3.kicad_pcb]
2026-01-21 component placement
    [myocell_s3.kicad_pcb]
2026-01-30 drdy fixed
    [cpu_wroom_esp32.kicad_sch, myocell_s3.kicad_pcb, myocell_s3.kicad_sch]
2026-02-04 spi routed length aligned to 20mm/pm0.5mm
    [myocell_s3.kicad_pcb, myocell_s3.kicad_sch]
2026-02-09 tracing ADS1298
    [myocell_s3.kicad_pcb, myocell_s3.kicad_sch]
2026-02-11 tracing RLD
    [myocell_s3.kicad_pcb]
2026-02-13 tracing pwr
    [myocell_s3.kicad_pcb]
2026-02-16 tracing power
    [myocell_s3.kicad_pcb]
2026-02-18 tracing analogue interfaces
    [adc_8.kicad_sch, myocell_s3.kicad_pcb]
2026-02-27 tracing polygons
    [adc_8.kicad_sch, myocell_s3.kicad_pcb]
2026-03-03 placing polygons
    [myocell_s3.kicad_pcb, myocell_s3.kicad_sch, power_supply.kicad_sch]
2026-03-04 polygon tuning
    [myocell_s3.kicad_pcb]
2026-03-09 start DRC
    [myocell_s3.kicad_pcb]
2026-03-10 adjust electrode positions
    [myocell_s3.kicad_pcb]
2026-03-15 sent to rezonit
    [myocell_s3.kicad_pcb]
2026-03-15 interactive BOM added
2026-03-16 schematic pdf updated
2026-10-10 esp32-s3 support for board myocell-3s rev1
2026-10-15 sync bug fixed in tcp_task (forget to give back mutex). restart adc added after wrong header received from adc. CPU clock set to 240MHz
2026-10-31 прошивка для платы myocell-s3 на Rust + клиент для десктопа
